GLOXIOU/MIDI-controller-DIY/images/img-26.png

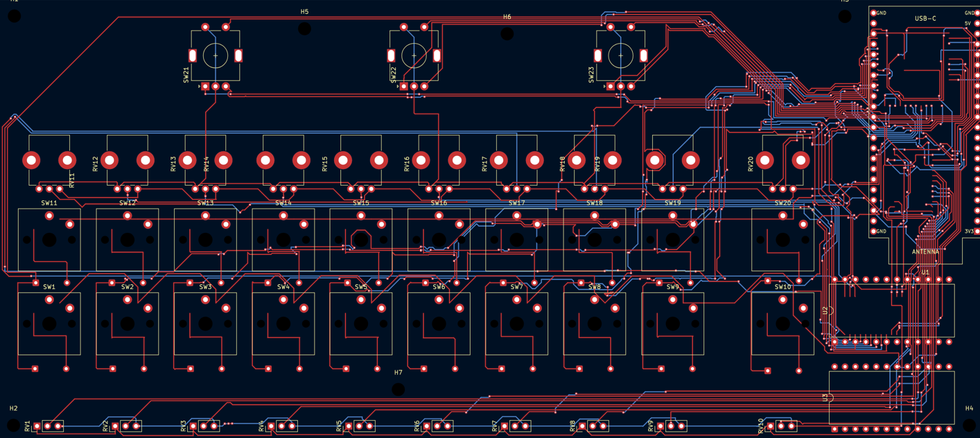
images/img-26.png
