GLOXIOU/MIDI-controller-DIY/images/img-27.png

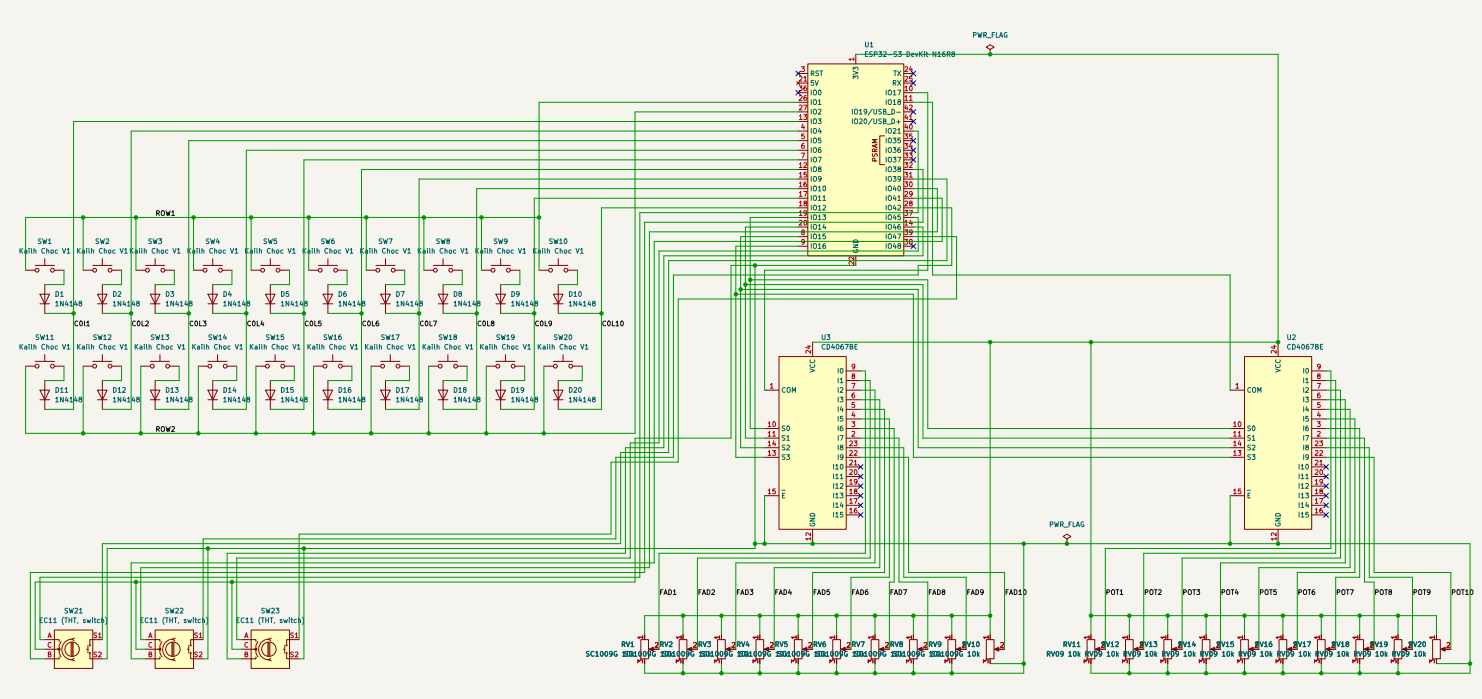
images/img-27.png
