GLOXIOU/MIDI-controller-DIY/images/img-28.png

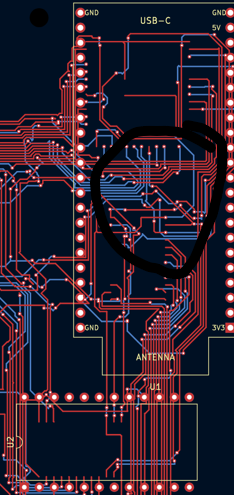
images/img-28.png
