GLOXIOU/MIDI-controller-DIY/images/img-29.png

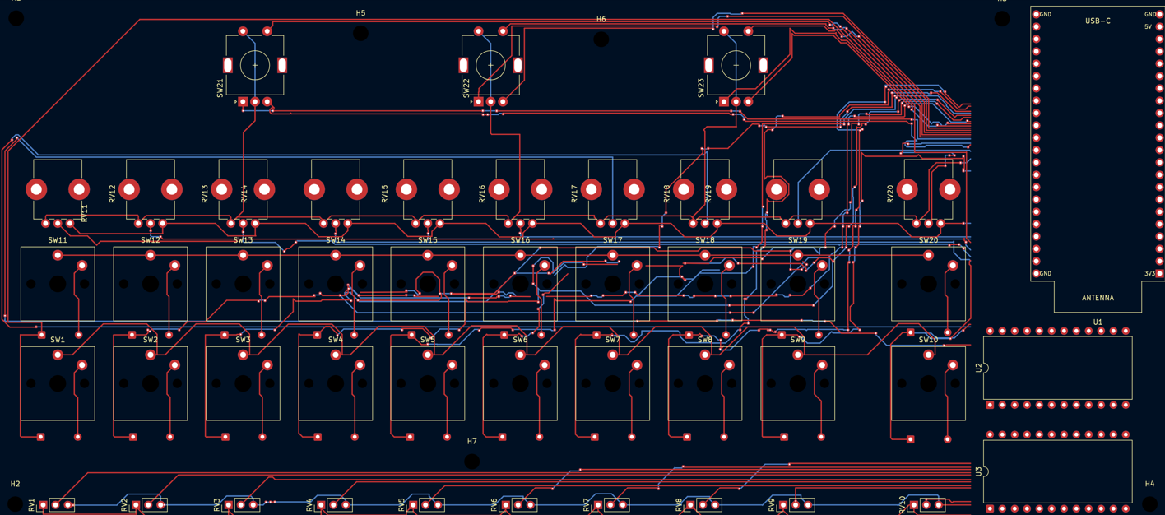
images/img-29.png
