GLOXIOU/MIDI-controller-DIY/images/img-30.png

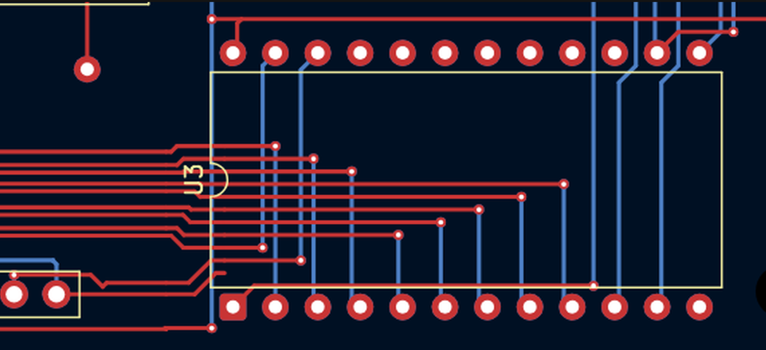
images/img-30.png
