GLOXIOU/MIDI-controller-DIY/images/img-31.png

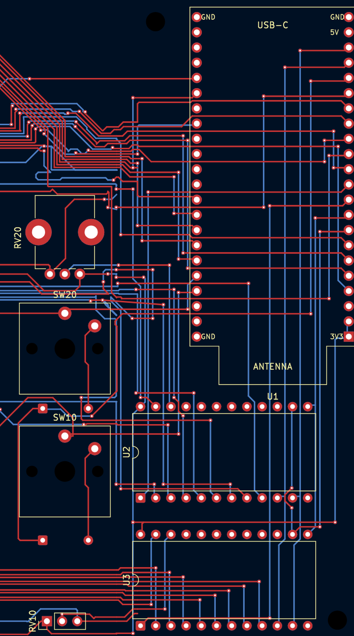
images/img-31.png
