GLOXIOU/MIDI-controller-DIY/images/img-32.png

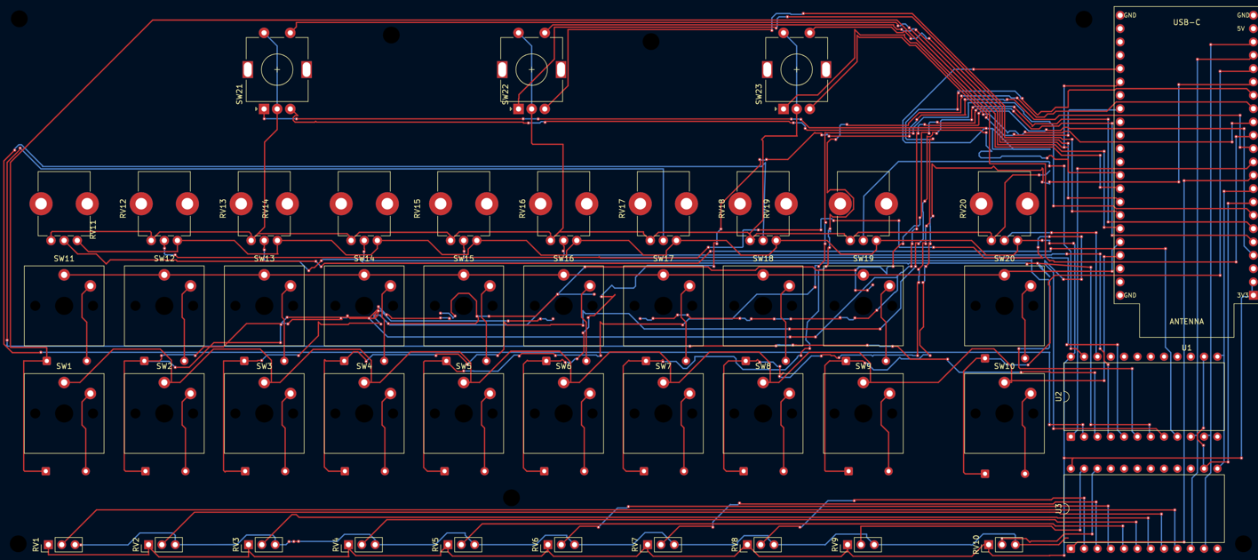
images/img-32.png
