GLOXIOU/MIDI-controller-DIY/images/img-34.png

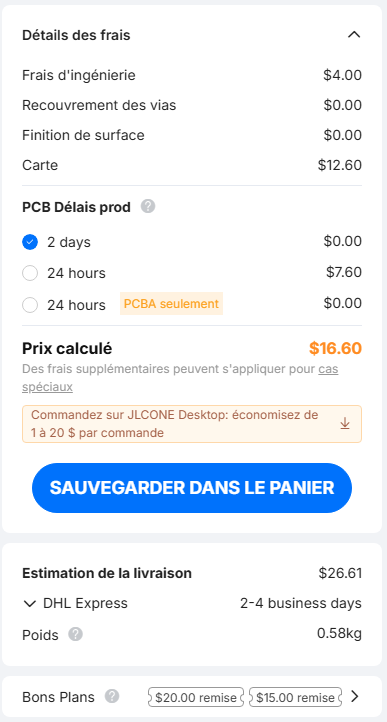
images/img-34.png
