GLOXIOU/MIDI-controller-DIY/images/img-35.png

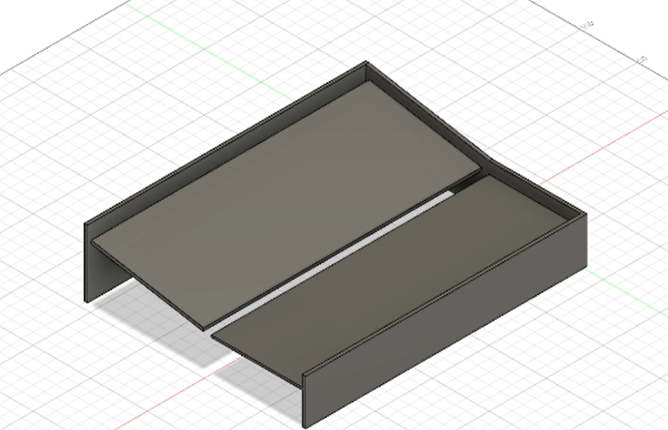
images/img-35.png
