GLOXIOU/MIDI-controller-DIY/images/img-36.png

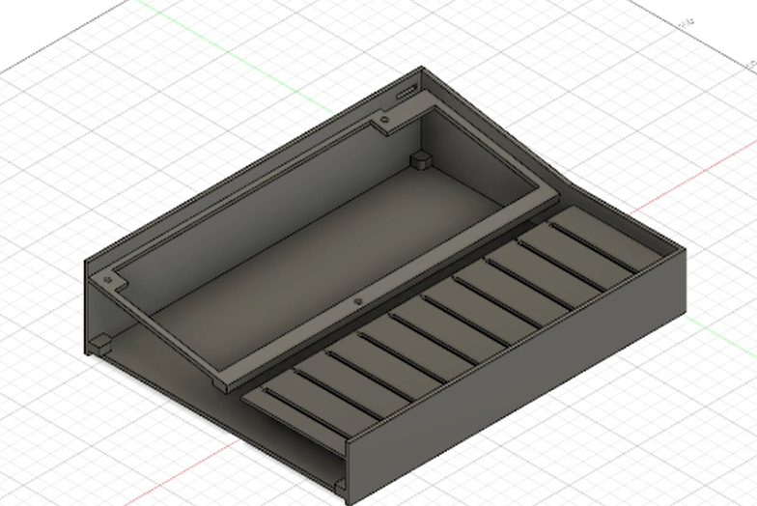
images/img-36.png
