GLOXIOU/MIDI-controller-DIY/images/img-37.png

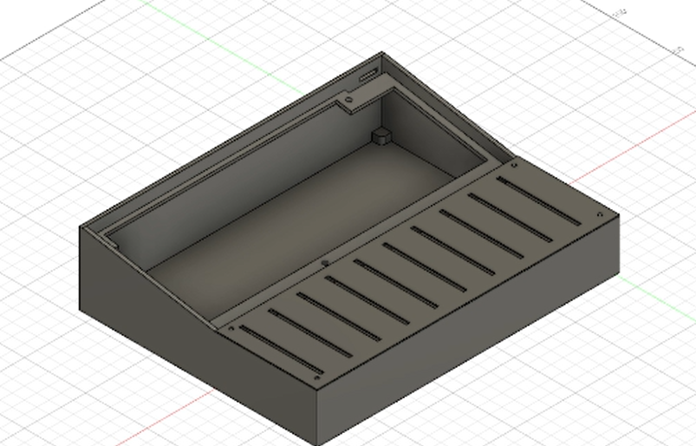
images/img-37.png
