GLOXIOU/MIDI-controller-DIY/images/img-38.png

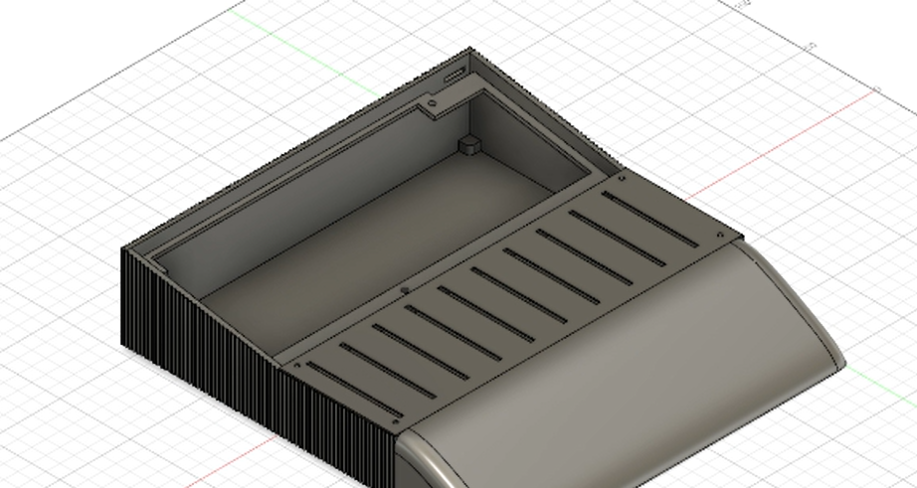
images/img-38.png
