GLOXIOU/MIDI-controller-DIY/images/img-39.png

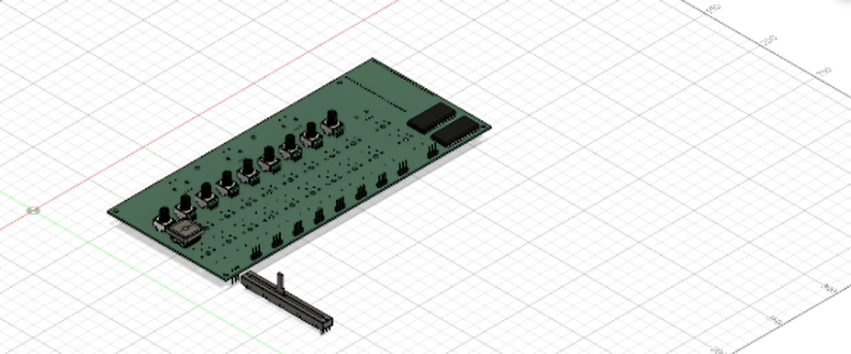
images/img-39.png
