GLOXIOU/MIDI-controller-DIY/images/img-40.png

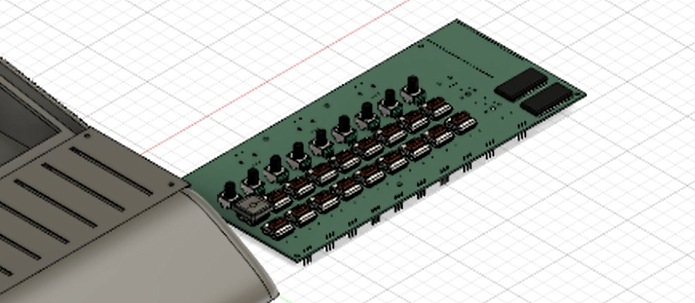
images/img-40.png
