GLOXIOU/MIDI-controller-DIY/images/img-41.png

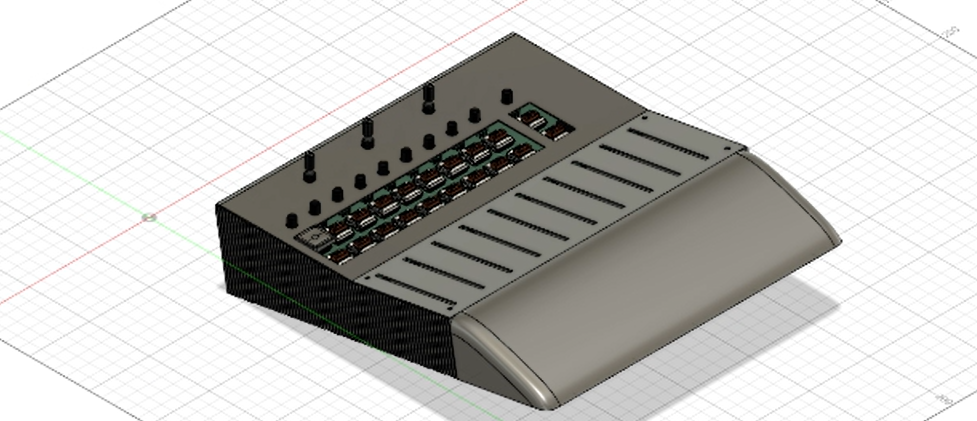
images/img-41.png
