GLOXIOU/MIDI-controller-DIY/images/img-42.png

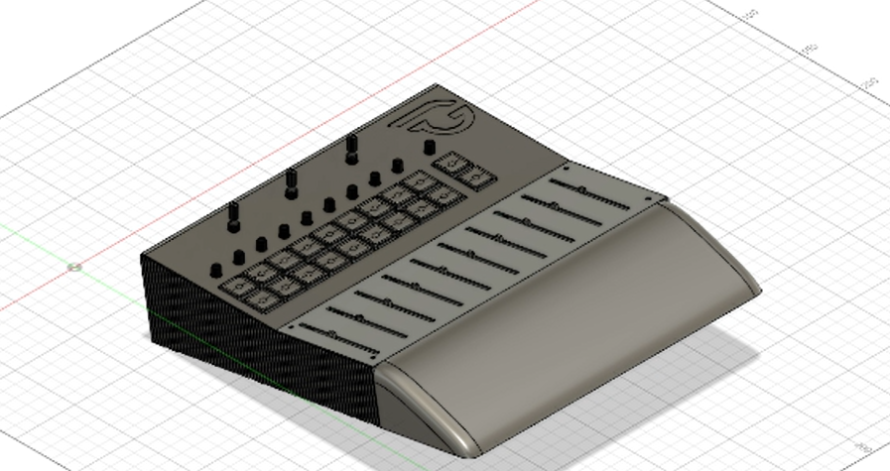
images/img-42.png
