GLOXIOU/MIDI-controller-DIY/images/img-43.png

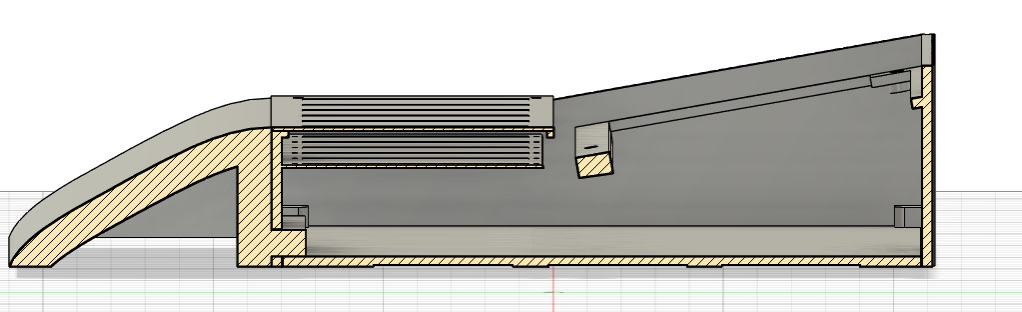
images/img-43.png
