GLOXIOU/MIDI-controller-DIY/images/img-44.png

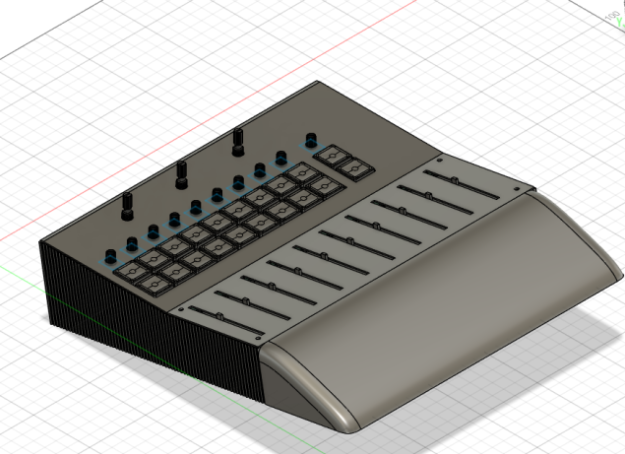
images/img-44.png
