GLOXIOU/MIDI-controller-DIY/images/img-45.png

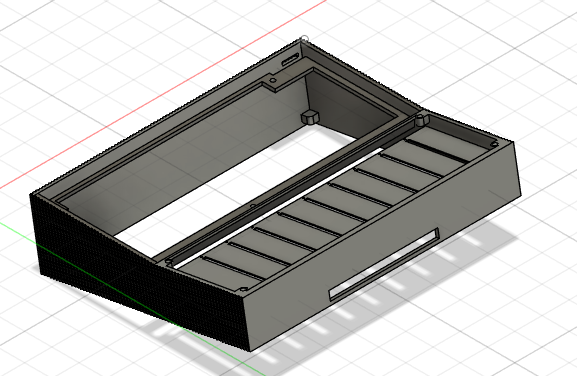
images/img-45.png
