GLOXIOU/MIDI-controller-DIY/images/img-46.png

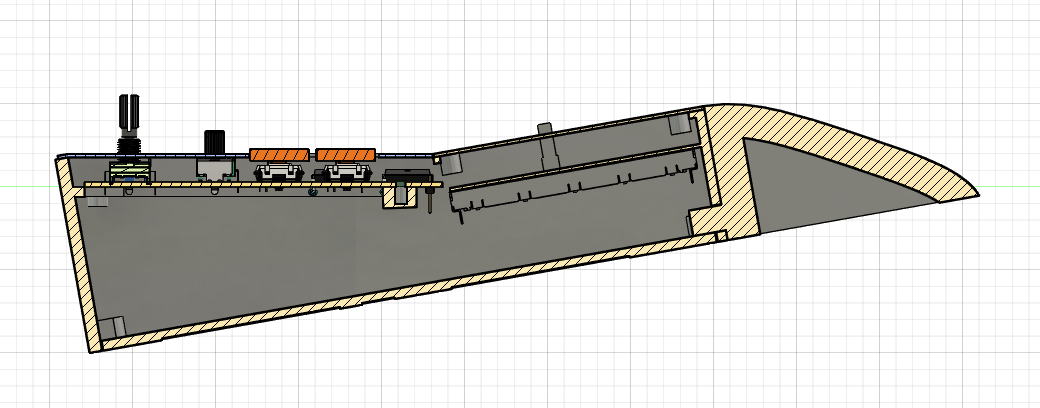
images/img-46.png
