GLOXIOU/MIDI-controller-DIY/images/img-47.png

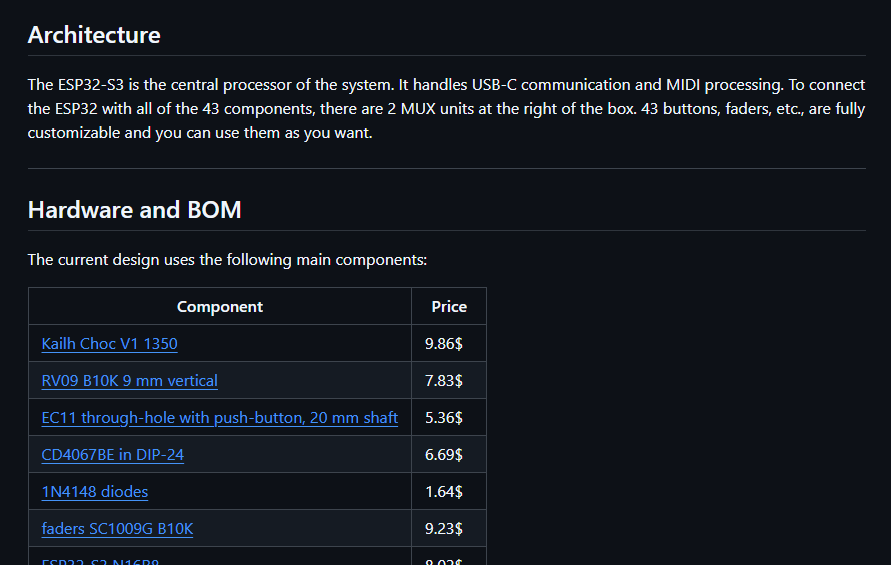
images/img-47.png
