GLOXIOU/MIDI-controller-DIY/images/img-48.png

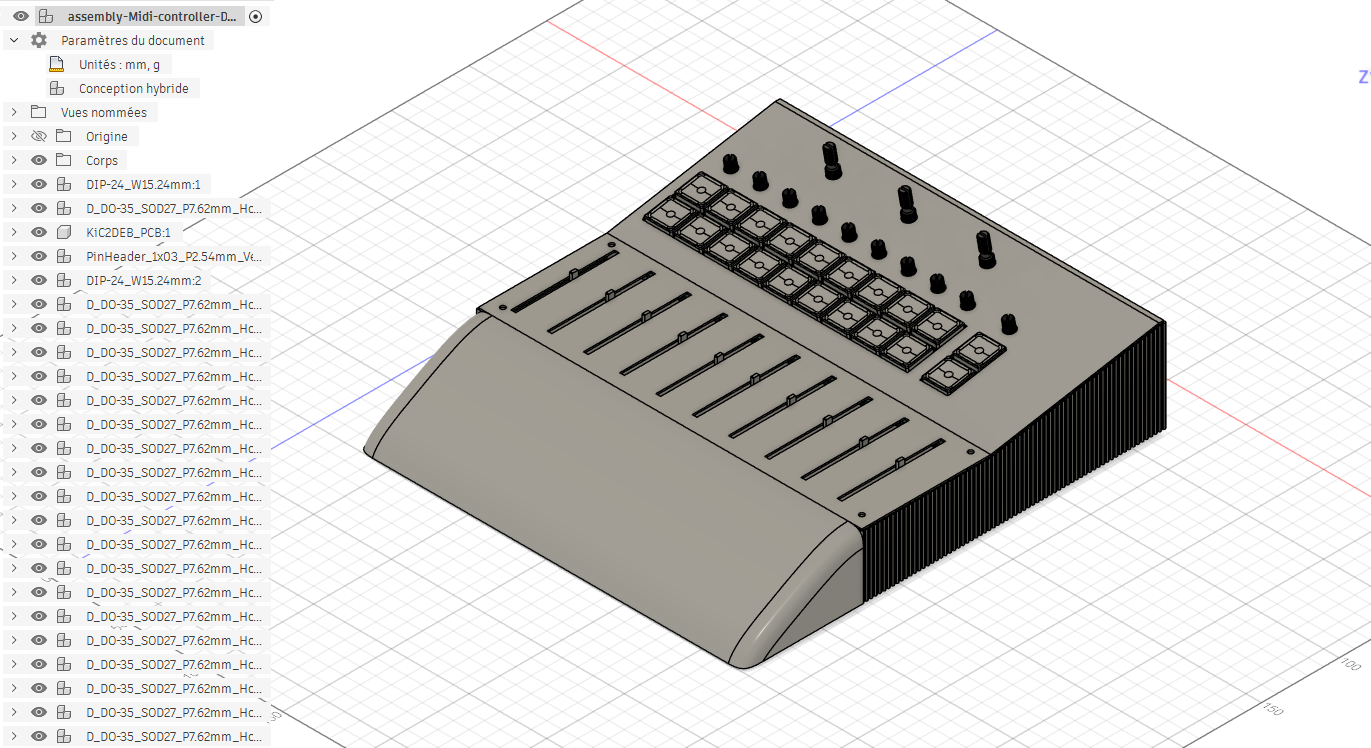
images/img-48.png
