GLOXIOU/MIDI-controller-DIY/images/img-49.png

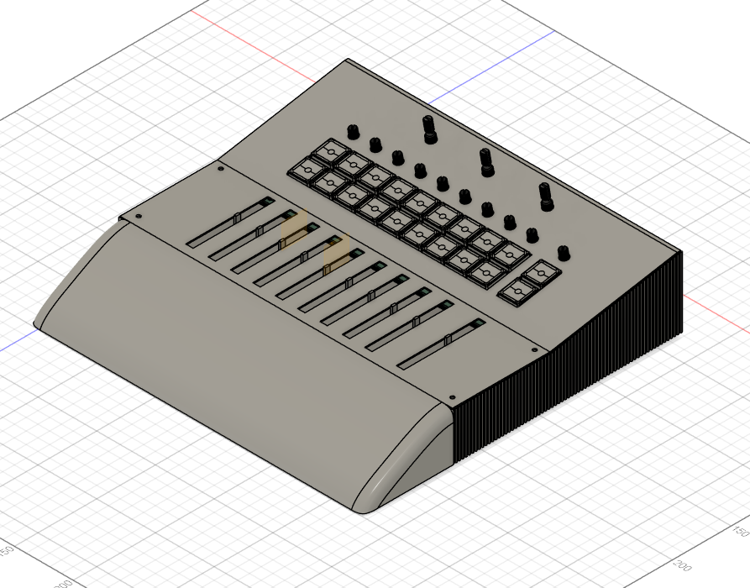
images/img-49.png
