GLOXIOU/MIDI-controller-DIY/images/img-50.png

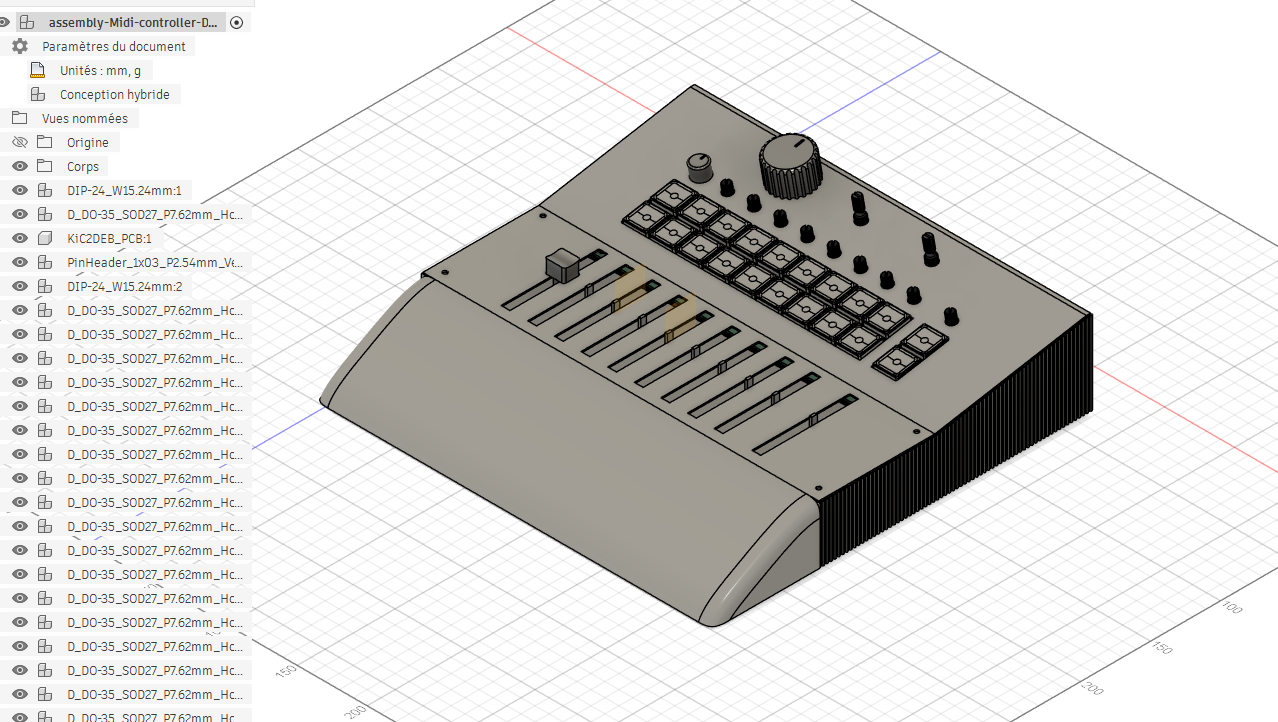
images/img-50.png
