GLOXIOU/MIDI-controller-DIY/images/img-51.png

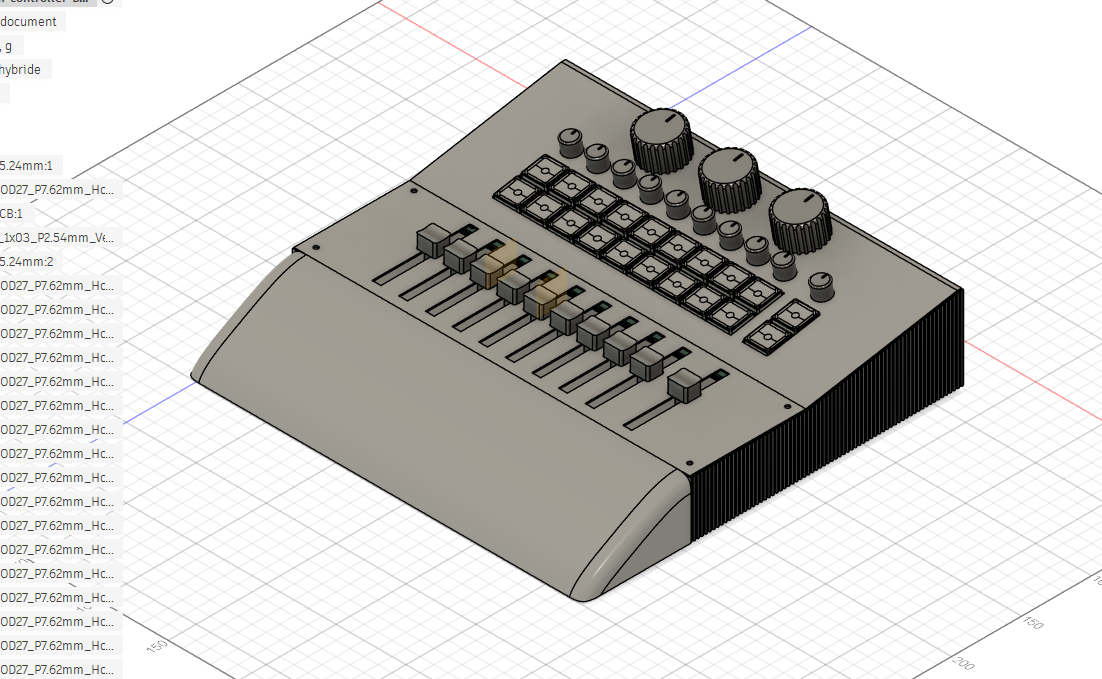
images/img-51.png
