GLOXIOU/MIDI-controller-DIY/3D-files/assembly-Midi-controller-DIY.step

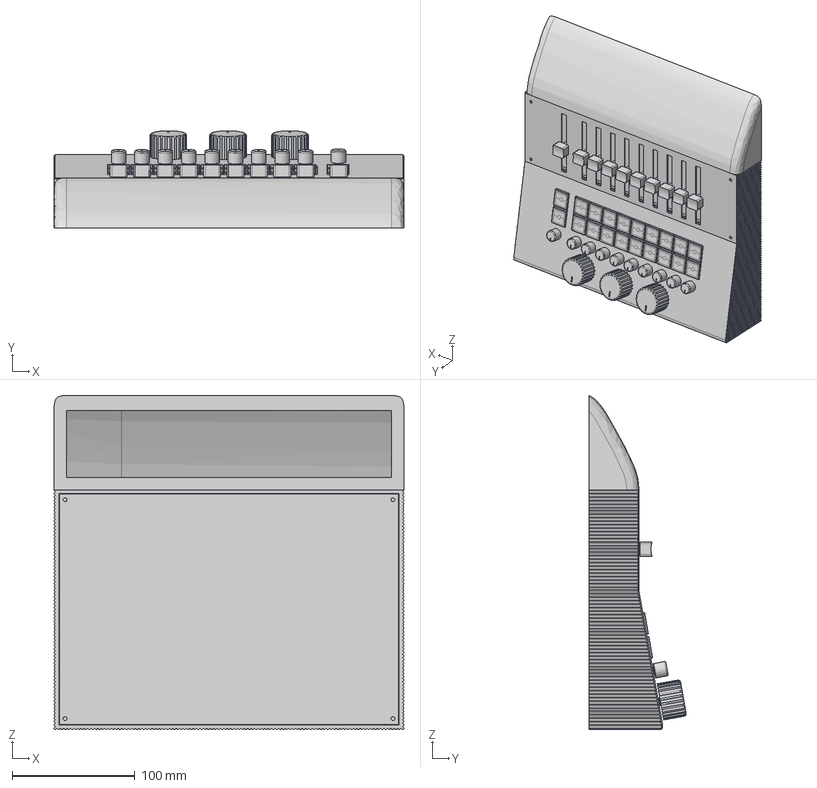
[picture p30: CAD file, 2026-11-03]
3D-files/assembly-Midi-controller-DIY.step
285.1 x 79.4 x 272.2 mm
DIP_24_W1524mm x 2
D_DO-35_SOD27_P7.62mm_Horizontal_1 x 20
KiC2DEB_PCB
PinHeader_1x03_P254mm_Vertical x 10
Document x 20
SLIDE_POTENTIOMETER_PLATE x 10
