GLOXIOU/MIDI-controller-DIY/3D-files/potentio_assem_asm.stp

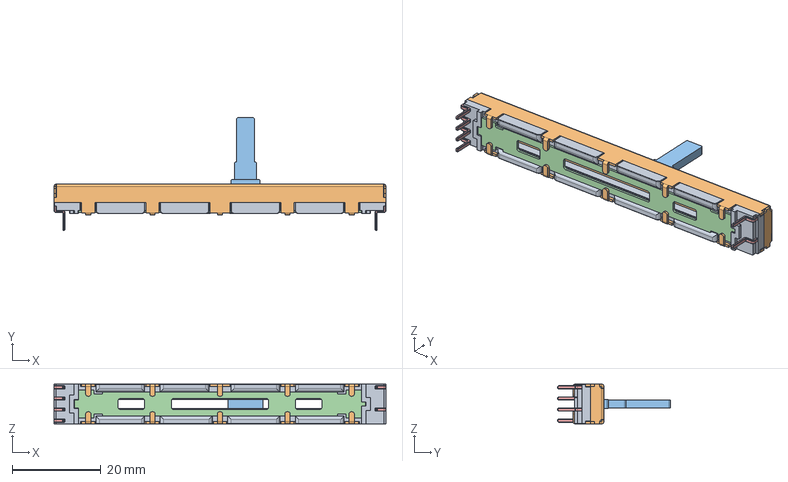
[picture p31: CAD file, 2026-10-31]
3D-files/potentio_assem_asm.stp
75.0 x 25.4 x 9.00 mm
SLIDE_POTENTIOMETER_BODY
SLIDE_POTENTIOMETER_COVER
SLIDE_POTENTIOMETER_BAR
SLIDE_POTENTIOMETER_PLATE
SLIDE_POTENTIOMETER_PIN x 6
