GLOXIOU/MIDI-controller-DIY/3D-files/Midi-controller-DIY-case.step

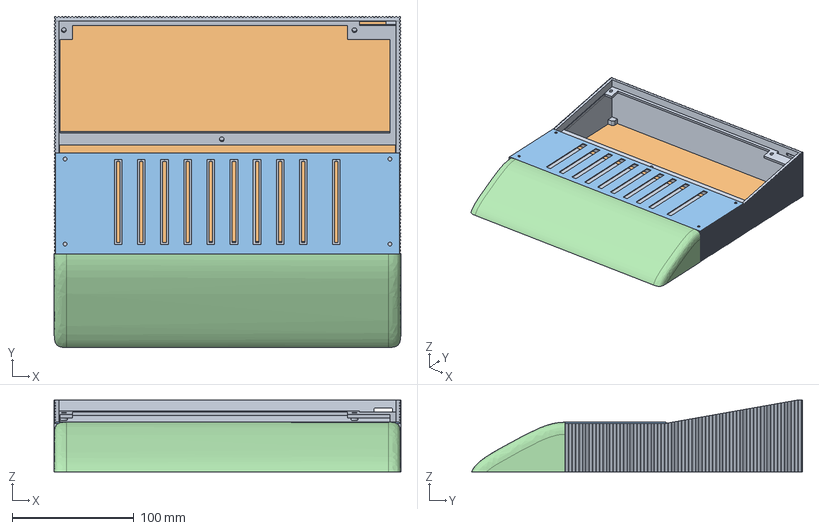
[picture p32: CAD file, 2026-11-03]
3D-files/Midi-controller-DIY-case.step
285.1 x 272.2 x 59.2 mm
