GLOXIOU/MIDI-controller-DIY/3D-files/to print/pot-knob-Midi-controller.stl

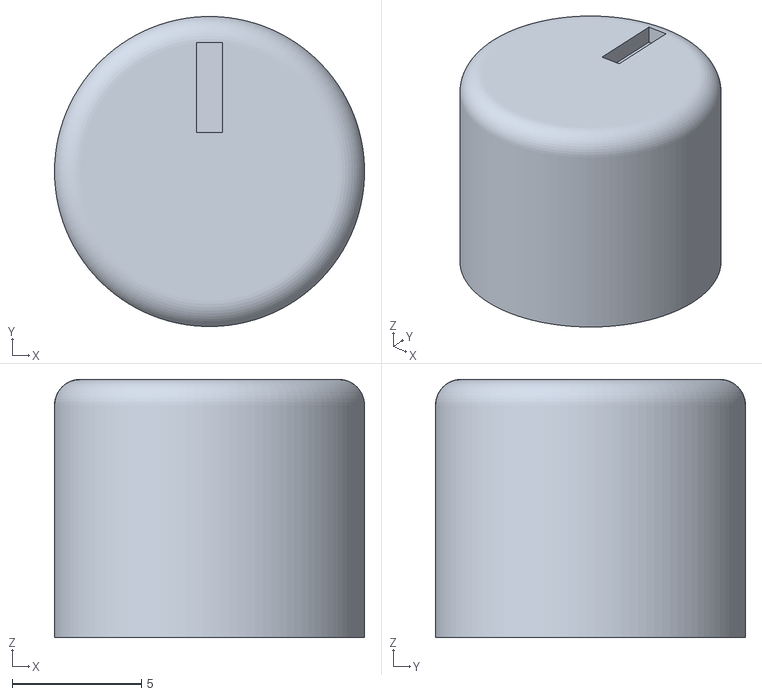
[picture p33: CAD file, 2026-11-03]
3D-files/to print/pot-knob-Midi-controller.stl
12.0 x 12.0 x 10.0
