GLOXIOU/MIDI-controller-DIY/3D-files/to print/encoder-knob-Midi-controller.stl

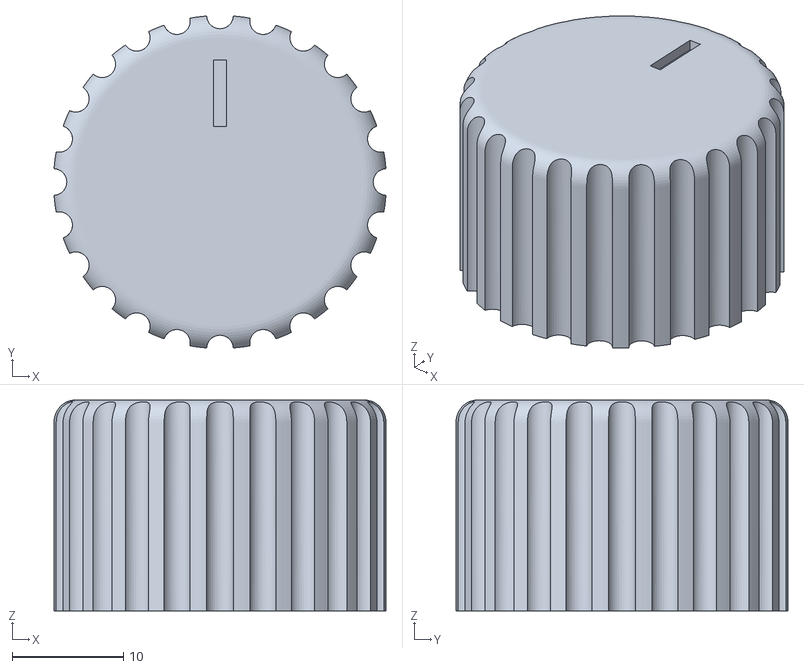
[picture p34: CAD file, 2026-11-03]
3D-files/to print/encoder-knob-Midi-controller.stl
29.9 x 29.9 x 19.0
