GLOXIOU/MIDI-controller-DIY/3D-files/to print/Wall-Midi-controller.stl

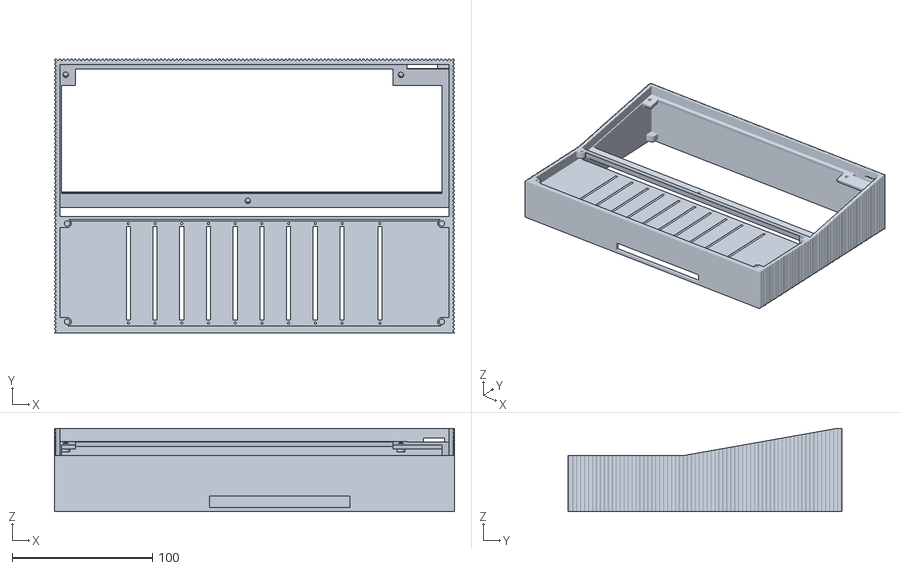
[picture p36: CAD file, 2026-11-03]
3D-files/to print/Wall-Midi-controller.stl
285.1 x 195.2 x 59.2
