GLOXIOU/MIDI-controller-DIY/3D-files/to print/ergo-Midi-controller.stl

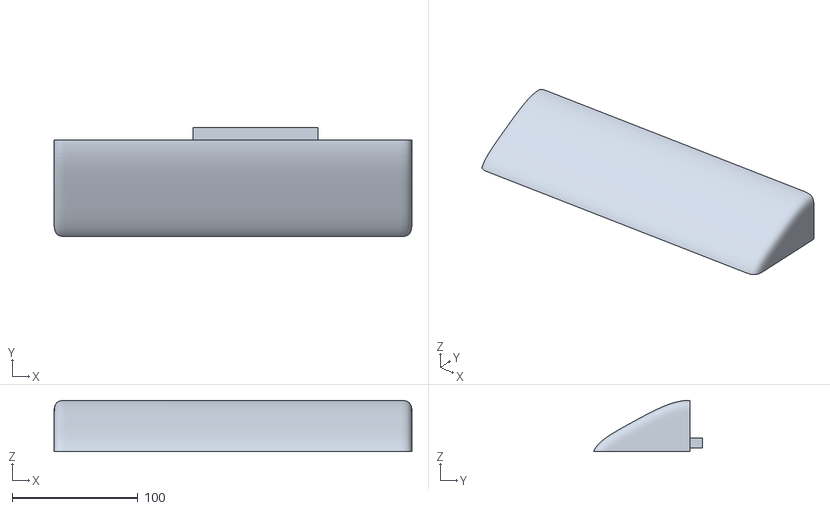
[picture p37: CAD file, 2026-11-03]
3D-files/to print/ergo-Midi-controller.stl
285.1 x 87.0 x 41.0
