GLOXIOU/MIDI-controller-DIY/3D-files/Diode 1N4148.STEP

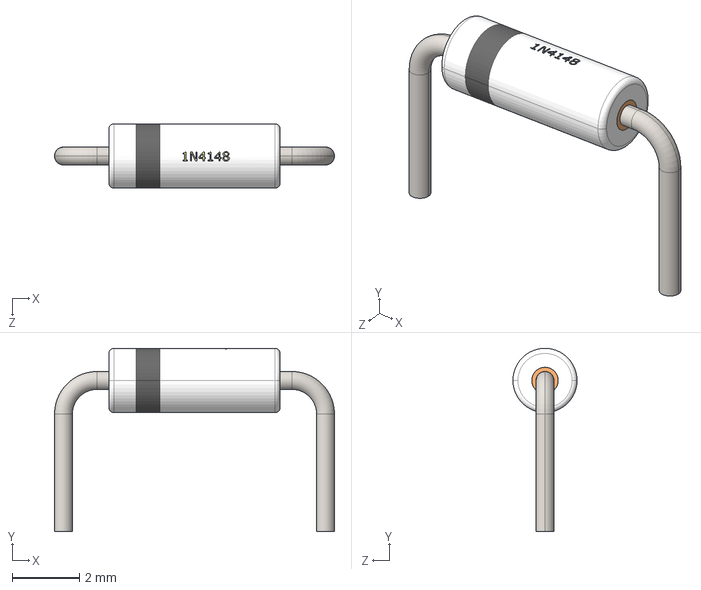
[picture p38: CAD file, 2026-10-31]
3D-files/Diode 1N4148.STEP
8.33 x 5.46 x 1.91 mm
