GLOXIOU/MIDI-controller-DIY/3D-files/to print/fader-cap-Midi-controller.stl

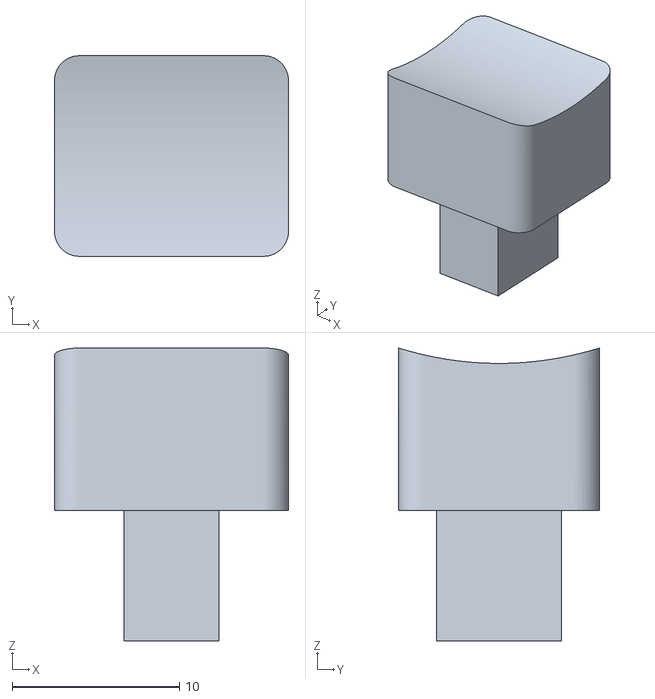
[picture p39: CAD file, 2026-11-03]
3D-files/to print/fader-cap-Midi-controller.stl
14.0 x 12.0 x 17.5
