GLOXIOU/MIDI-controller-DIY/3D-files/PCB.step

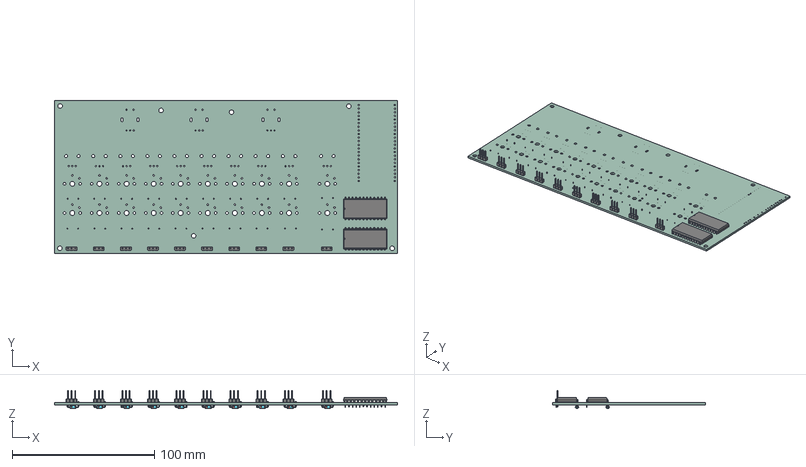
[picture p40: CAD file, 2026-10-31]
3D-files/PCB.step
241.0 x 107.8 x 12.7 mm
PinHeader_1x03_P254mm_Vertical x 10
DIP_24_W1524mm x 2
D_DO-35_SOD27_P7.62mm_Horizontal x 20
KiC2DEB_PCB
