GLOXIOU/MIDI-controller-DIY/3D-files/to print/key-plate-Midi-controller.stl

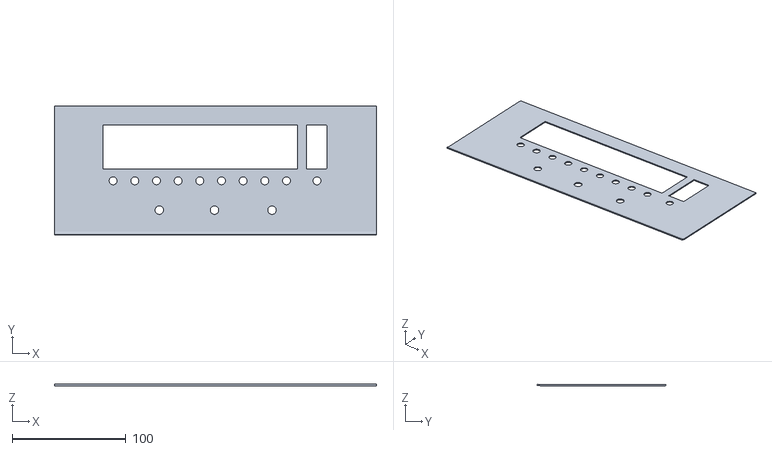
[picture p41: CAD file, 2026-11-03]
3D-files/to print/key-plate-Midi-controller.stl
283.1 x 113.1 x 1.51
