GLOXIOU/MIDI-controller-DIY/3D-files/Grove Fader Cap.step

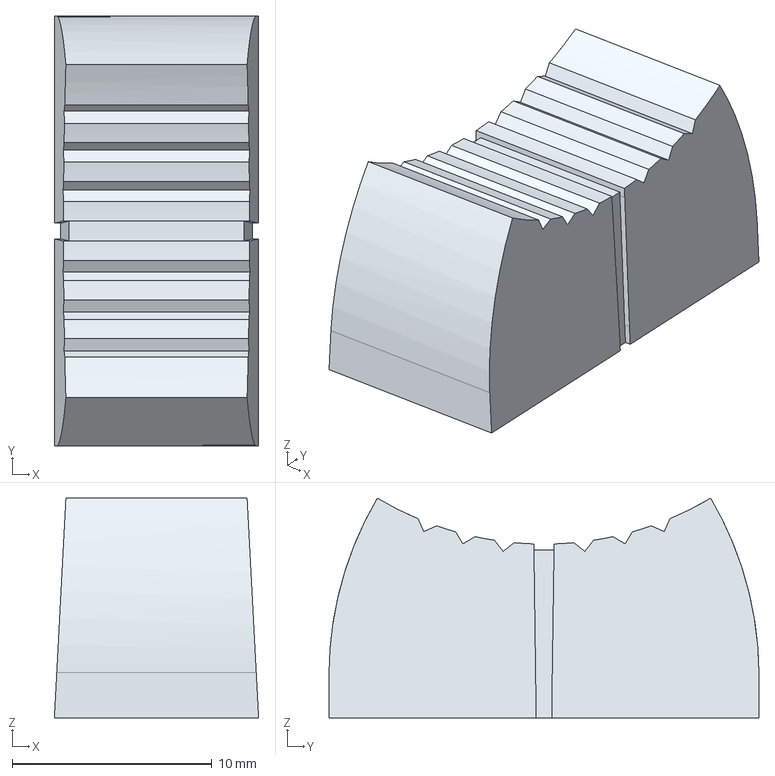
[picture p42: CAD file, 2026-10-31]
3D-files/Grove Fader Cap.step
10.2 x 21.5 x 11.0 mm
