GLOXIOU/MIDI-controller-DIY/3D-files/to print/plate-Midi-controller.stl

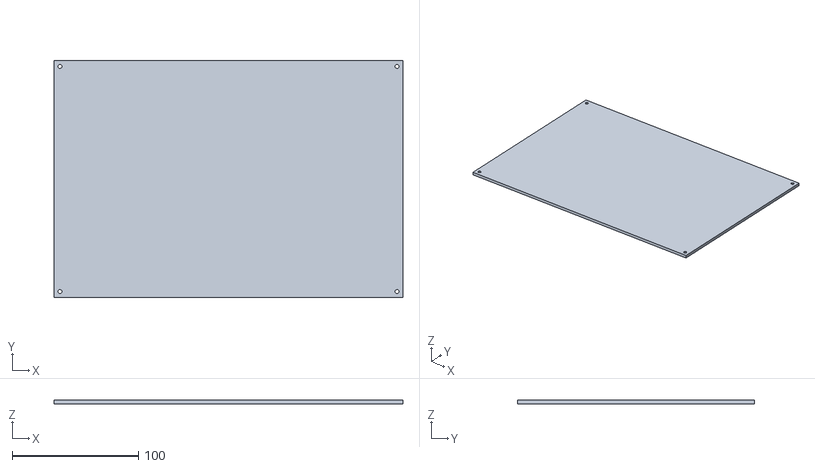
[picture p43: CAD file, 2026-11-03]
3D-files/to print/plate-Midi-controller.stl
276.5 x 187.7 x 3.00
