GLOXIOU/MIDI-controller-DIY/3D-files/to print/fader-cover-Midi-controller.stl

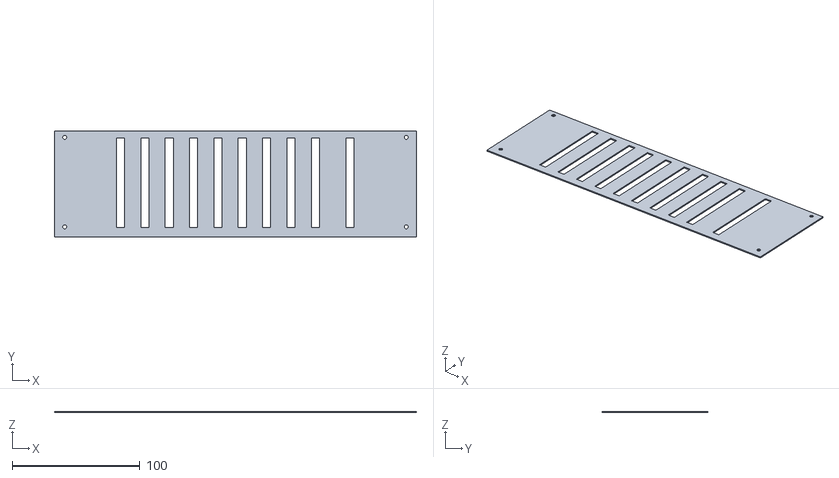
[picture p44: CAD file, 2026-11-03]
3D-files/to print/fader-cover-Midi-controller.stl
283.1 x 83.0 x 1
