GLOXIOU/MIDI-controller-DIY/JOURNAL.md

| title | MIDI-controller-DIY |
| --- | --- |
| author | GLOXIOU |
| description | A DIY project for a MIDI controller designed to control lights, featuring knobs, faders, and buttons. |
| created_at | 2026-09-23 |

# Day 1: Defining system & idea search & inspiration

I want to make a MIDI controlleur to control my lights via my already made [DMX Unit](https://github.com/GLOXIOU/DMX-Unit-DIY), with 9 faders, 1 master fader, for all of the faders, 2 keyboards low profile key, and 2 potentiometer. I also want 2 larger rotary encoders with push-button function. All of that in a box, designed in 3D in Fusion 360, and for the first time in my life with a PCB. All of that will be managed by an ESP32-S3, and I want just a USB-C output for the MIDI.

My inspiration is the GrandMa, wich cost around 7000$. I want to make that, but for much cheaper, and with just the functionality I need. The only thing I want to keep from that housing is the utility.

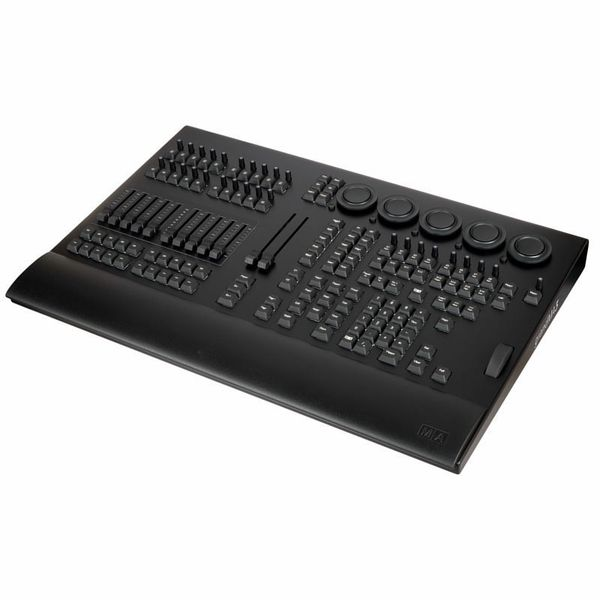
[picture p45: images/img-1.jpg]


So I started by making a litlle schema of what I want and what I imagine:

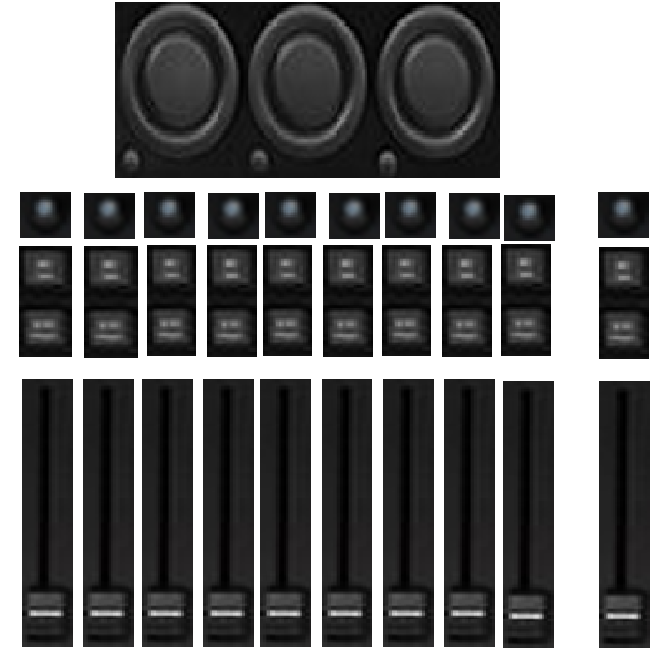
[picture p46: images/img-2.jpg]


Why 9 faders and 1 master ? Beacause on Aliexpress, tehre's only lots of 10 pieces. But that might changes, like maybe I will add 5 or I don't know. For the parts, I check online and talk to some friends, and apprenntly, this is the best:

* SC1009G Fader 10K Ohms x10
* EC11 rotary encoder x3 (I need to make the large wheel above the potentiometer in 3D)
* WH148 10K omhs x10
* Kailh 1350 Choc V1 - Brown switch x20

For a price arround 50 dollars with the PCB I believe, but it's need to be confirmed. The last time I order on aliexpress, I payed duble the price beacause of the importation tax in europe, so I need to be carefull this time...

Nothing is finished yet, but here is where the project stands at this point. Now that I have all this, I think the first step will be to design the PCB, so I can then create the 3D enclosure and finally work on the code.

Here's the actual BOM without the PCB, and the componments may changed.

| Componment | Price |
| --- | --- |
| [SC1009G x10](https://fr.aliexpress.com/item/1005005672998771.html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) | 13$ (1,30/u) |
| [EC11 x5](https://fr.aliexpress.com/item/1005006076665259.html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) | 3,71$ (0,74$/u) |
| [WH148 10K x10](https://fr.aliexpress.com/item/1005002490613561.html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) | 4,96$ (0,49$/u) |
| [Kailh 1350 Choc V1](https://fr.aliexpress.com/item/1005012826040037.html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) | 10,72$ (1,07$/u) |
| Deliverie/Importation | 16,14$ |
| Total | 60,11$ |

To that, we need to add the keycaps for the 10 keyboard key, and the PCB. ~+20$, so the total for now is around 80 dollars.

**Total time spent: 2 hours**

# Day 2: Finishing the componments grill and starting the PCB

Today I started by cheking the componments list that I mad the oder day. Turns out that it's missing something ! The ESP32 does not have enough analogics input for the project. So I made some inquiries.

I need 20 analogic signals, 10 for the sliders and 10 others for the WH148. So for those, I add 2xCD4067. They have 16 canals each, so that will be 32 in total. It's 4,67$ for 5 pices.

For the 20 low profiles keys, I need a matrix. That will reduce the number of pin from 20 to 9. But to do the matrix, I need 20 diodes 1N4148 to block the current that could flow back. That cost 1,64$ dollars for 100 pieces. That's verry cheap ! Here's a litlle schema to understand what's a matrix:

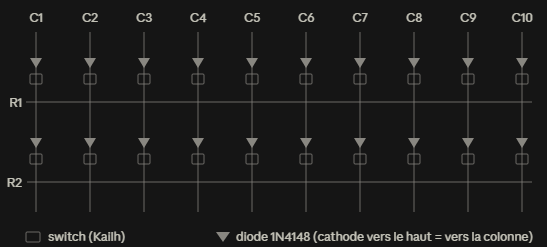
[picture p47: images/img-3.png]


So here's the new BOM:

| Componment | Price |
| --- | --- |
| [SC1009G x10](https://fr.aliexpress.com/item/1005005672998771.html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) | 13$ (1,30/u) |
| [EC11 x5](https://fr.aliexpress.com/item/1005006076665259.html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) | 3,71$ (0,74$/u) |
| [WH148 10K x10](https://fr.aliexpress.com/item/1005002490613561.html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) | 4,96$ (0,49$/u) |
| [Kailh 1350 Choc V1](https://fr.aliexpress.com/item/1005012826040037.html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) | 10,72$ (1,07$/u) |
| [CD4067](https://fr.aliexpress.com/item/1005007374271804.html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) | 4,67$ |
| [1N4148](https://fr.aliexpress.com/item/4000142272546.html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) | 1,64$ |
| Deliverie/Importation | 30,28$ |
| Total | 74,25$ |

Then, I watch [this tutorial](https://www.youtube.com/watch?v=dAck3bxzehA) of KiCad. I never done a PCB in my life, so that will not be easy. I watch it multiple time to understand how to do all the things.

Now that I know a litlle bit how to do it, with the help of the tutorial, I'm going to make the KiCad file. I started by the matrice, here's a litlle screenshot. I love making that, that's so interesting !

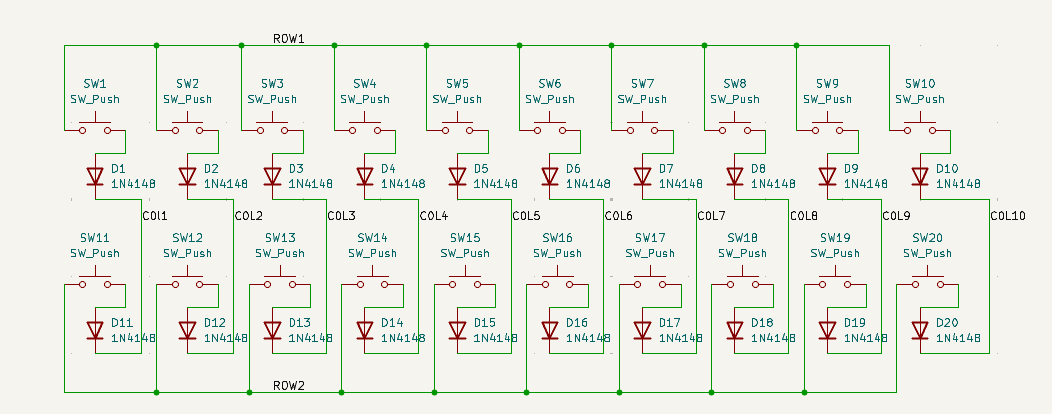
[picture p48: images/img-4.png]


Then I connected that to the ESP. I will continue tomorrow.

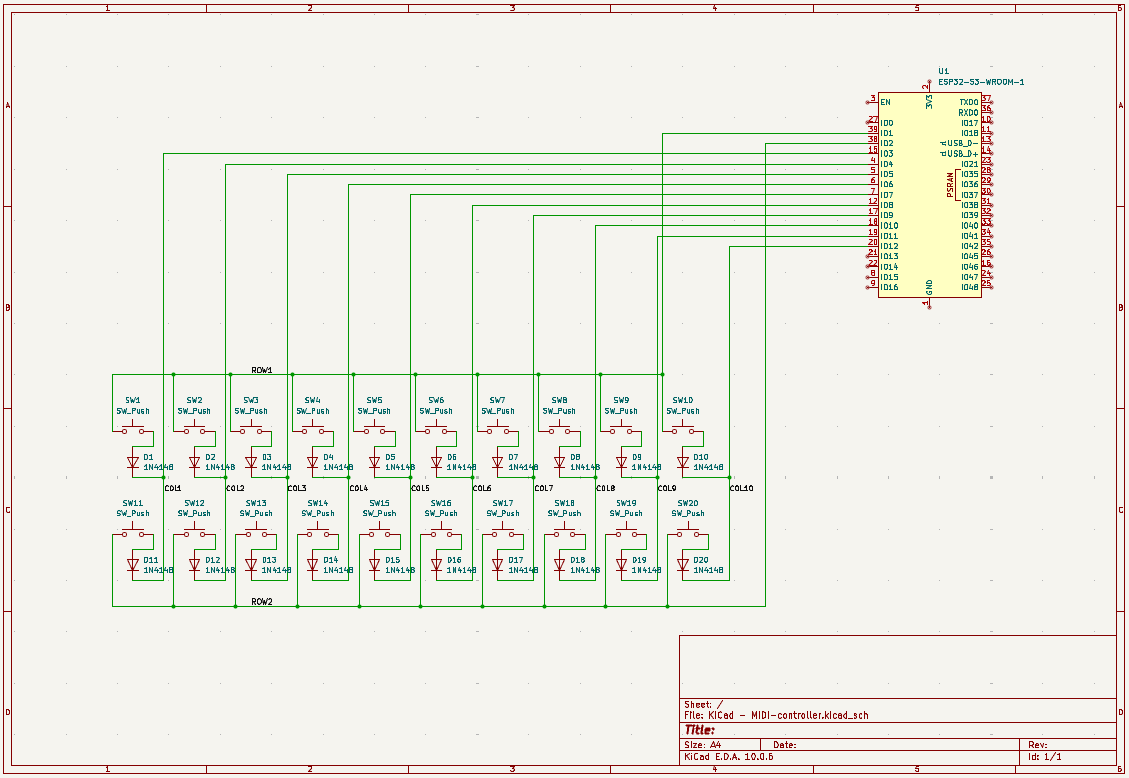
[picture p49: images/img-5.png]


You can check all the KiCad related file in [this foleder](KiCad - MIDI-controller) if you want to !

**Total time spent: 3.5 hours**

# Day 3: Finishing the KiCad plan and testing

I started by importing the 2 CD4067.

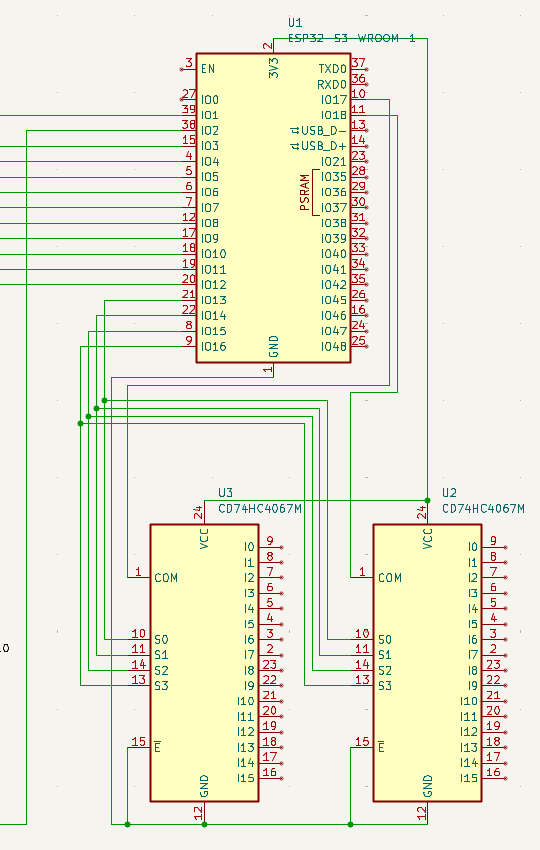
[picture p50: images/img-6.png]


Then, I added the 10 faders, SC1009G on the first MUX1 (U3 module on the screenshot). I needed to enlarge the sheet, which is why some elements shifted:

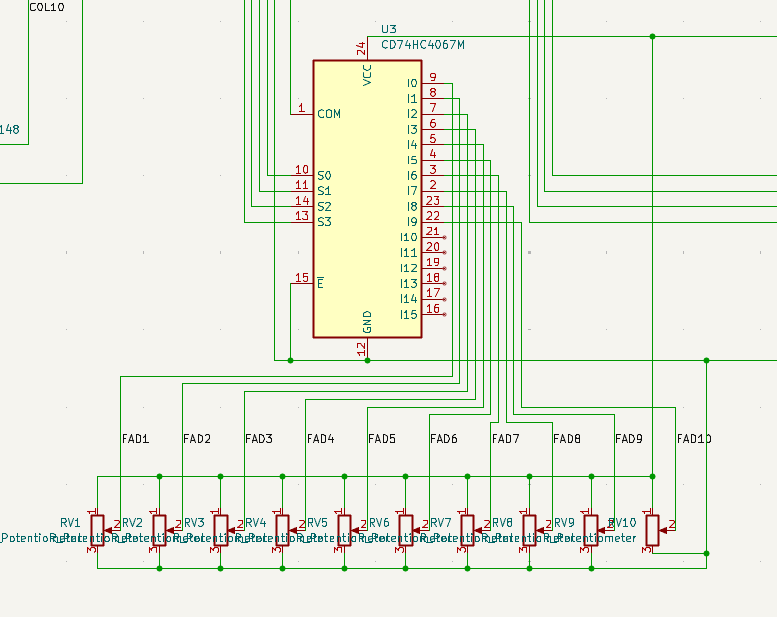
[picture p51: images/img-7.png]


Same thing for the 10 potentiometer WH148, but on the second MUX2, U2:

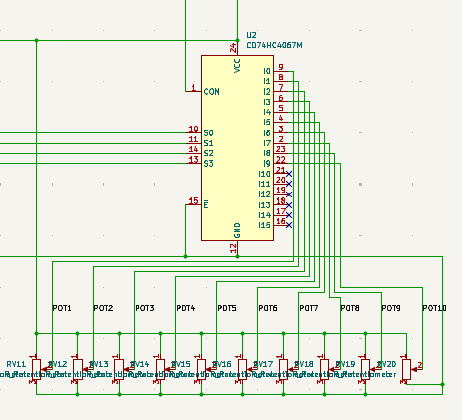
[picture p52: images/img-8.png]


After that, I aded the 3 rotary encoder switch and connected it on the ESP32:

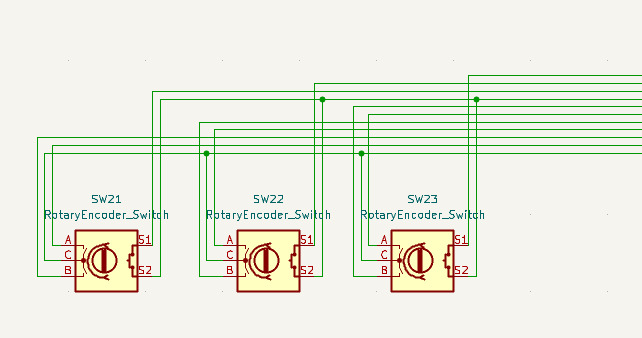
[picture p53: images/img-9.png]


So here's the final look of the KiCad sheet. Later, I'll send it to someone on Slack who knows KiCad well, so they can check that everything is working properly.

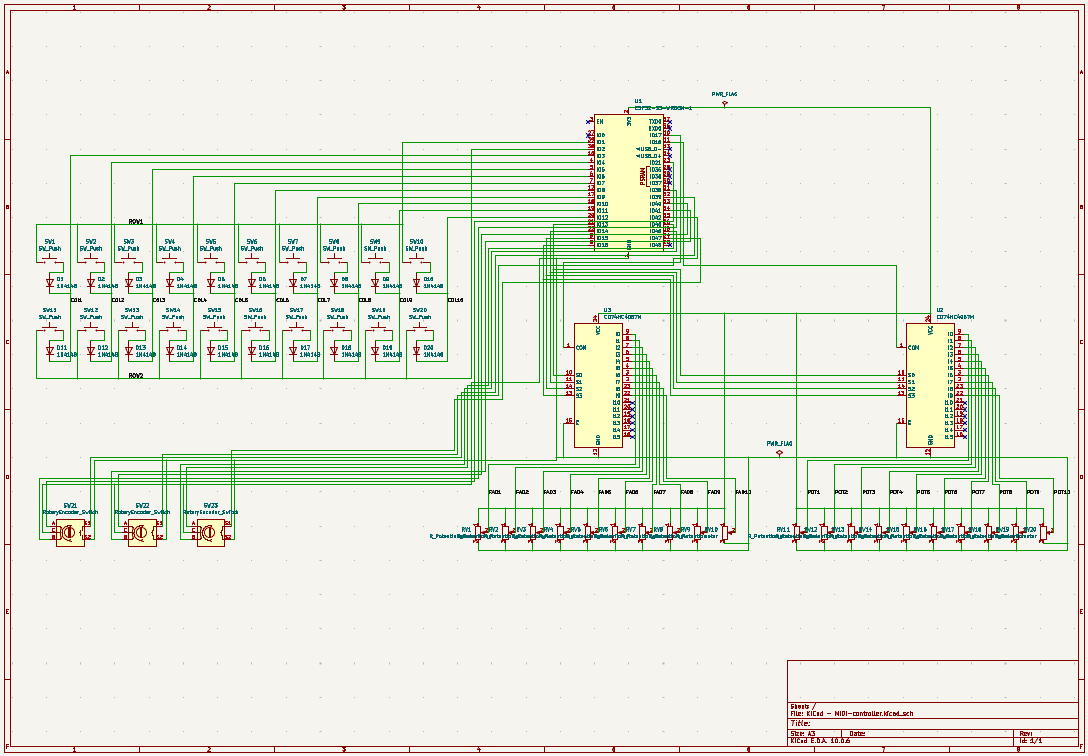
[picture p54: images/img-10.png]


I finished by making the ERC test, wich past easaly.

Today was a lot of KiCad, this is why there's not much texte for today, but a lot of screen shot ! You can check all the files in [this folder](KiCad - MIDI-controller).

**Total time spent: 3 hours**

# Day 4: Starting the PCB

Like yestreday, today will be a lot of screenshot and not much texte. Now that I finished the KiCad plan, I need to make it a PCB.

So I continued to follow the tutorial, and started by updating the PCB in the PCB window of the logiciel. But, when I pressed F8 to update, a pop up showed up with 22 errors. Since I don't know anything about the software, I sent this screenshot to an LLM, which explained how to fix the problem.

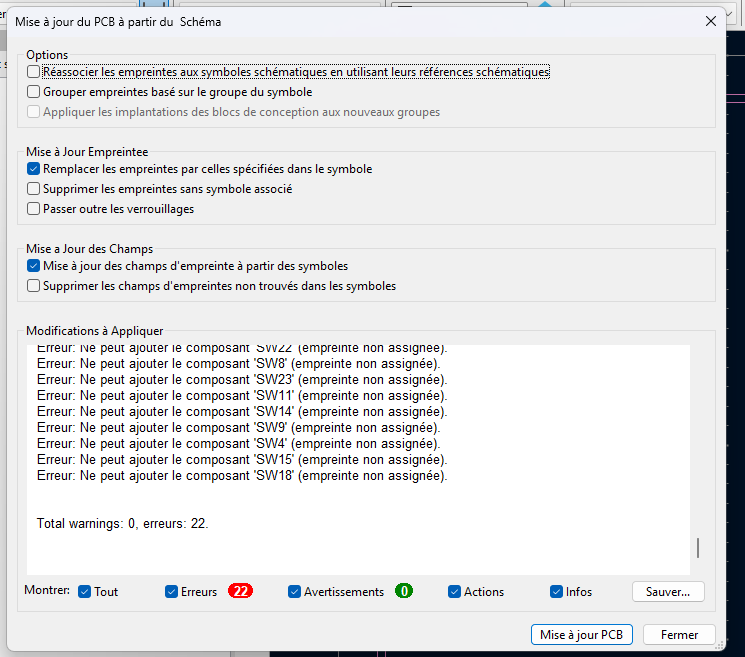
[picture p55: images/img-11.png]


Turns out that I just needed to assign the fingerprints... But that took me so much time ! I had to search online for the footprint of each of my components to add them to KiCad, find a workaround when those footprints weren't available in KiCad, and then double check everything at the end component by component... 

On top of that, I had to start all over again because I hadn't realized I needed to double click the fingerprint in addition to saving it... I won't make that mistake again !

Here is what it looks like:

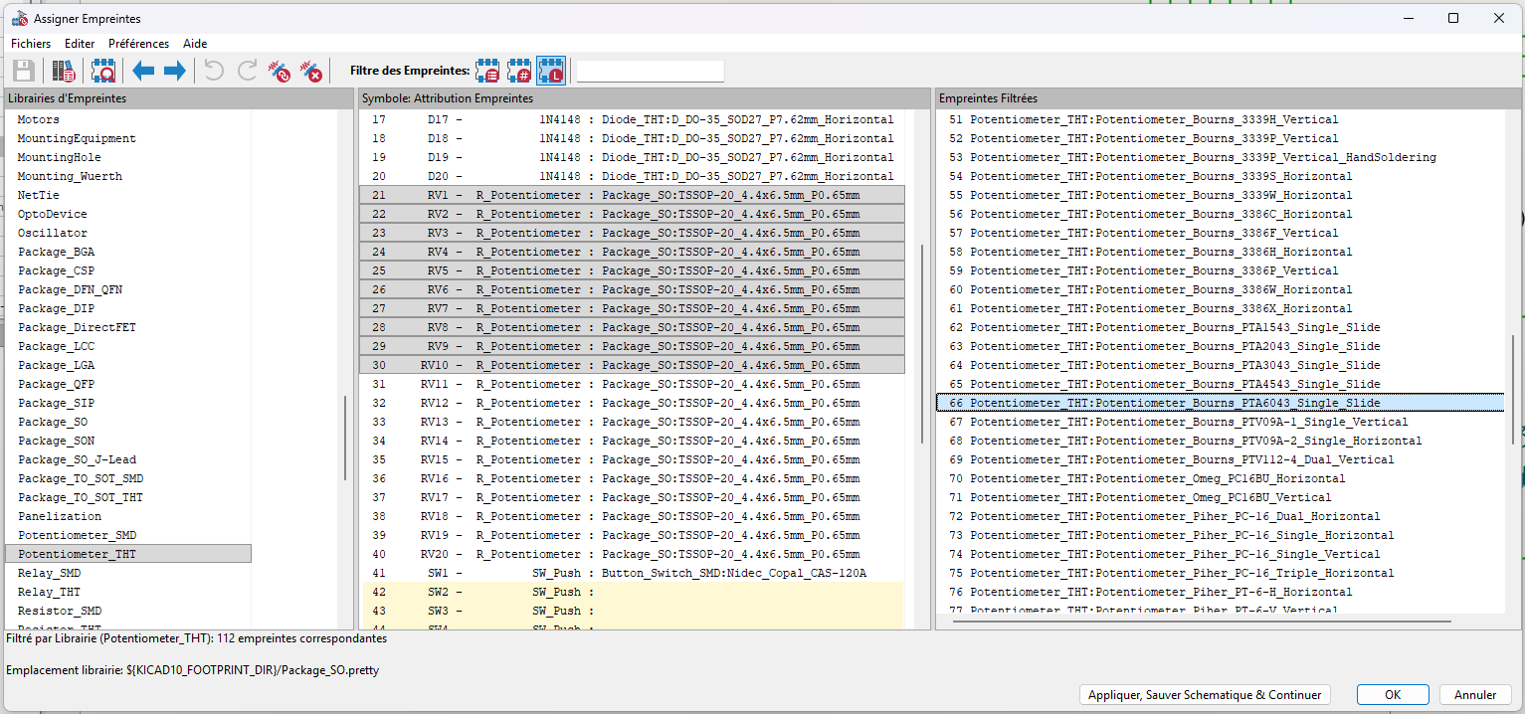
[picture p56: images/img-12.png]


So I did it, and now I can update the PCB without errors. Here's what it's look like for now, but it's verry unorganized, so I need to separate and place like I want all the compnments. The only problem is that I didn't find the right fingerprint for the fader, right now on the PCB it's some 60mm fader, so I need to check that later !

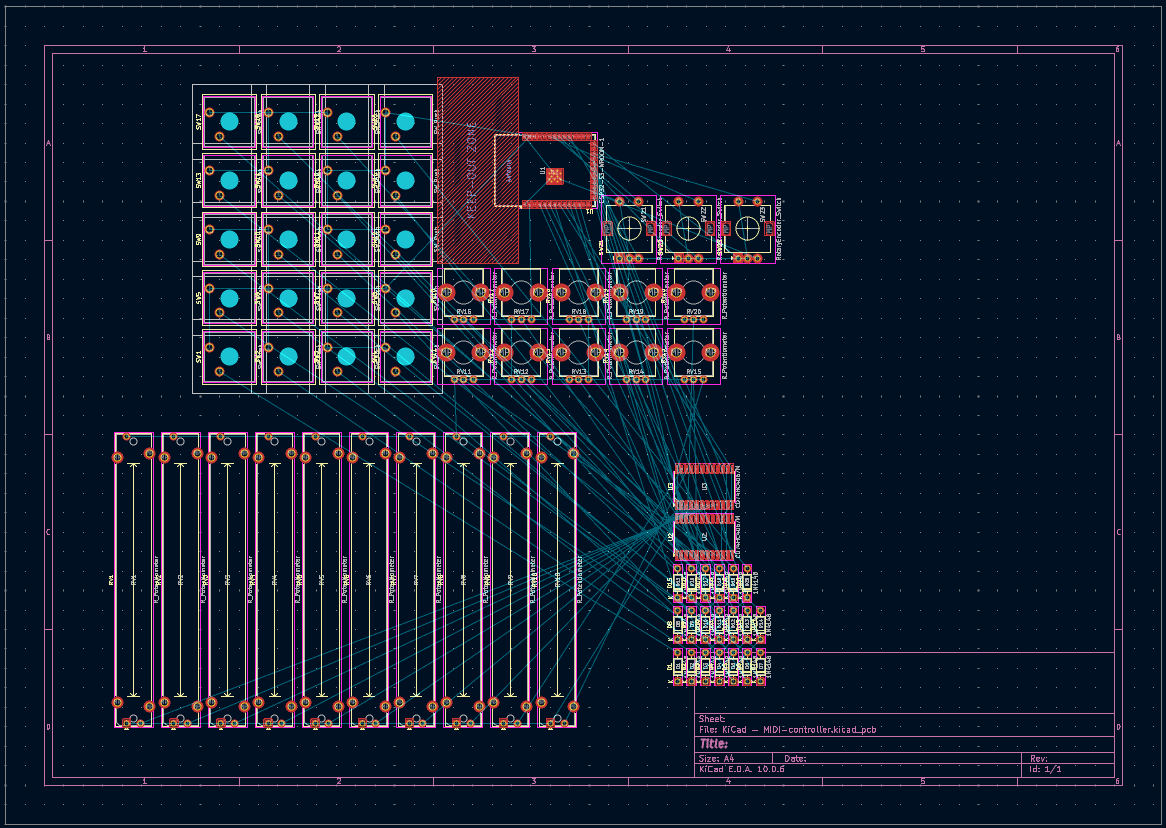
[picture p57: images/img-13.png]


Placing all the componment was also a long time to pass, but now it's done ! I’ll spare you the details regarding key spacing, vertical and horizontal alignment, the grid, and so on but of course, all of that was done!

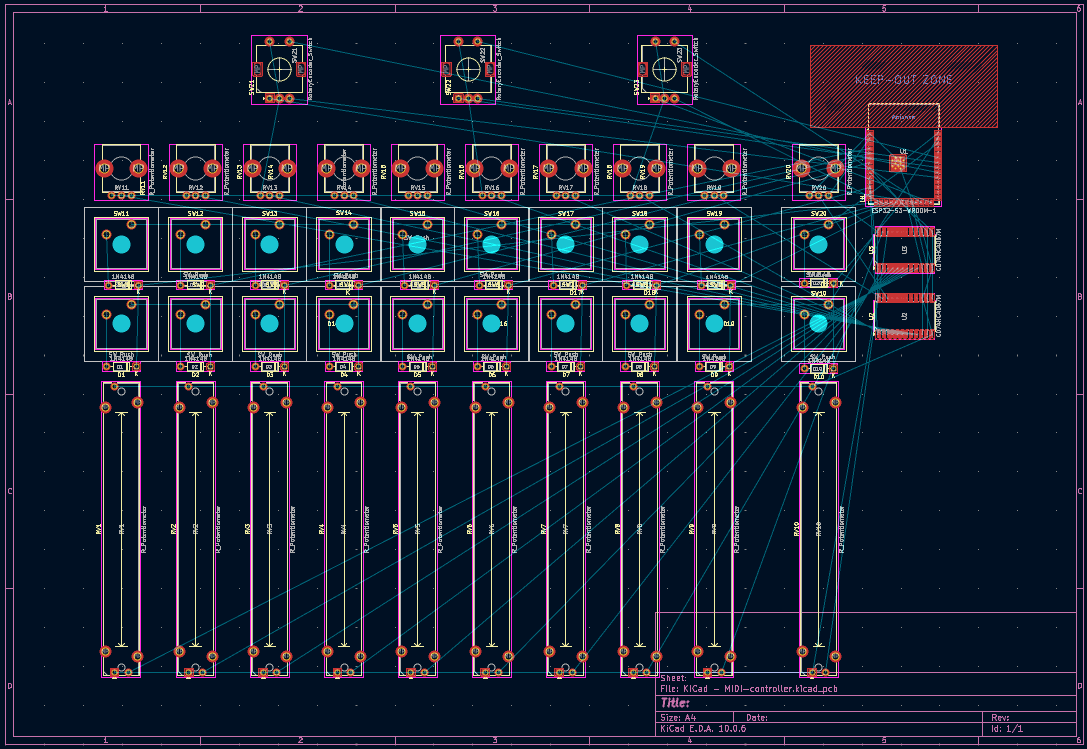
[picture p58: images/img-14.png]


Now I need to make the faders 100mm, and I need to trace the PCB outlines, and finish other stuff ! There's still a little bit of time left ! But for today, it's finished ! It might not look like it, but placing all the components in the right place and at the right distance took me a lot of time.

**Total time spent: 3 hours**

# Day 5: Continuing the PCB

I started by making the faders 100mm instead of 60mm. But, I spent an hour to look for a 100mm fingerprint, with NO result... So I’ve decided to change things up. I’m simply going to wire the faders directly, that way, I can avoid using a PCB and cut costs. I put the ```Connector_PinHeader_2.54mm:PinHeader_1x03_P2.54mm_Vertical``` fingerprint insted.

Then, I inverted the diodes on the back of the PCB, so I have the spac to put the keabords keys. Here's how the plan look right now:

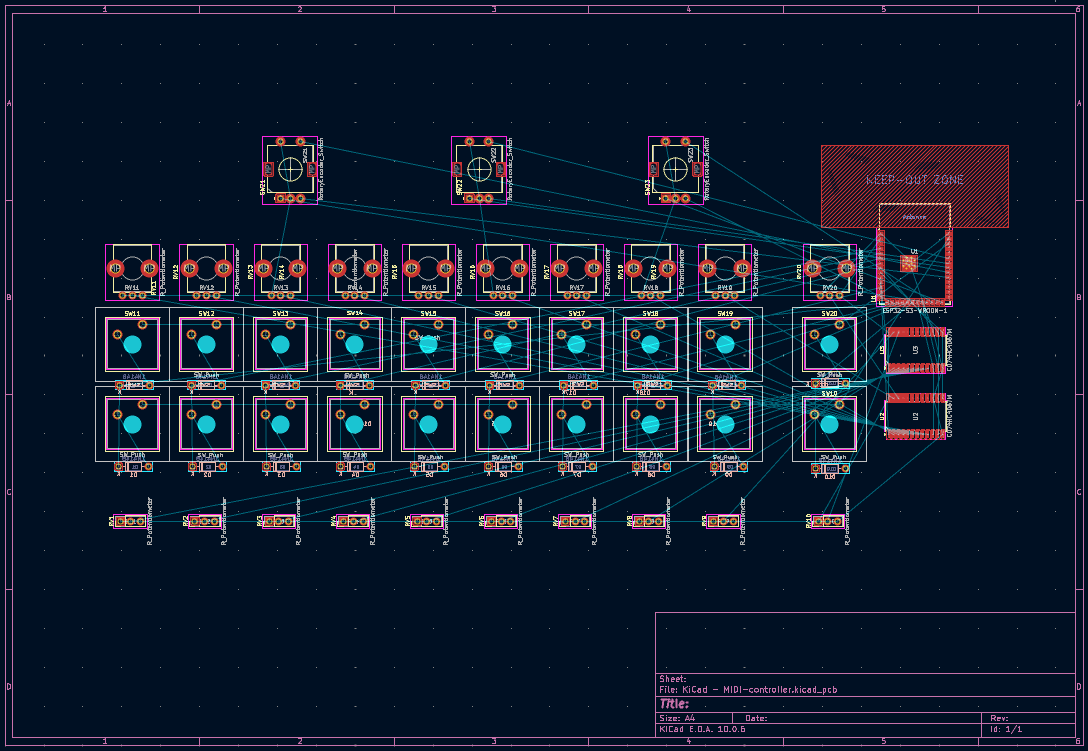
[picture p59: images/img-15.png]


After that, I drew the edge cut, and start the routing. I started by setting the track width to 0.25 mm in the settings.

I started by wiring up the entire matrix. I honestly thought it would take longer, but it wasn't bad! The most time-consuming part is the long connections linking the matrix to the ESP32. On this screenshot, these are all the small red connections.

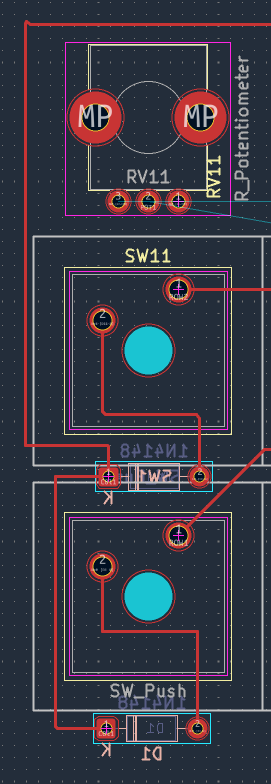
[picture p60: images/img-16.png]


The, I made the analogic connection, for the rotary encoder. For the rotary encoder, that was verry long and hard ! Beacause I needed to go all the way to the MUX... Here's how it's looking rihgt now:

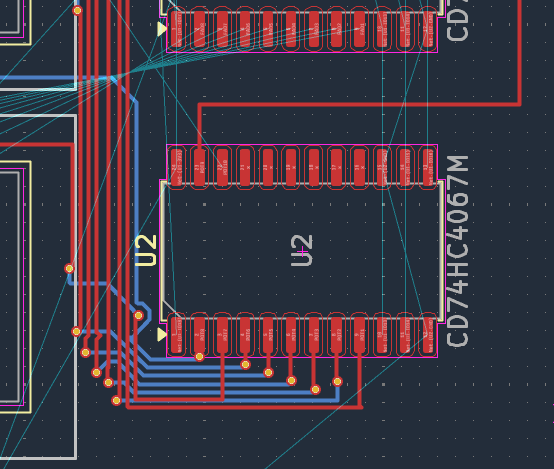
[picture p61: images/img-17.png]


It might not be very neat, but there are so many wires to run! I did the best I could. So after that, I made the wiring fot the faders.



And it's all for today ! The only thing that's missing are the three large rotary encoders and the MUX/ESP32 connections. That really won't take long.

**Total time spent: 3.5 hours**

# Day 6: Finishing the PCB ! Finnaly...

I'm starting to get fed up with making this PCB... I hope it'll be finished soon !

I started by tackling the wire routing. First, I finished wiring the faders I only had two left to do and then I started working on the three rotary encoders. I needed to enlarge the PCB just a little bit. So here's how it's looking so far



That is verry long, I had to start almost all over again because I had glued the ESP32 and the MUXes too close together. I shamefully thought I was going to have to abandon the project because of the PCB, but with a lot of time, I managed to fix the problems.

Here is the area I moved and where I had to redo a large part of the routing:

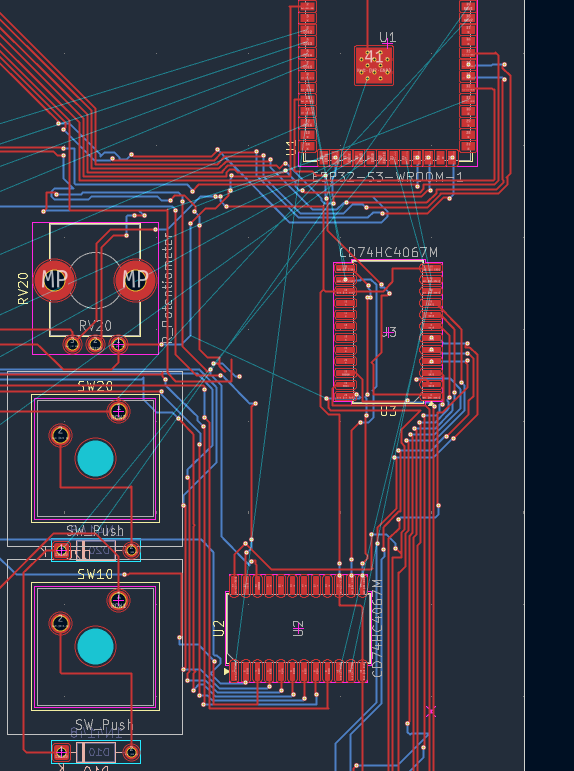
[picture p62: images/img-20.png]


Now that I have made that, I just need to wired up a few bits on the matrix, and finished off the wiring between the ESP and the MUXes. Here is the final result, finally ! All of that fixes was ssooooo long !

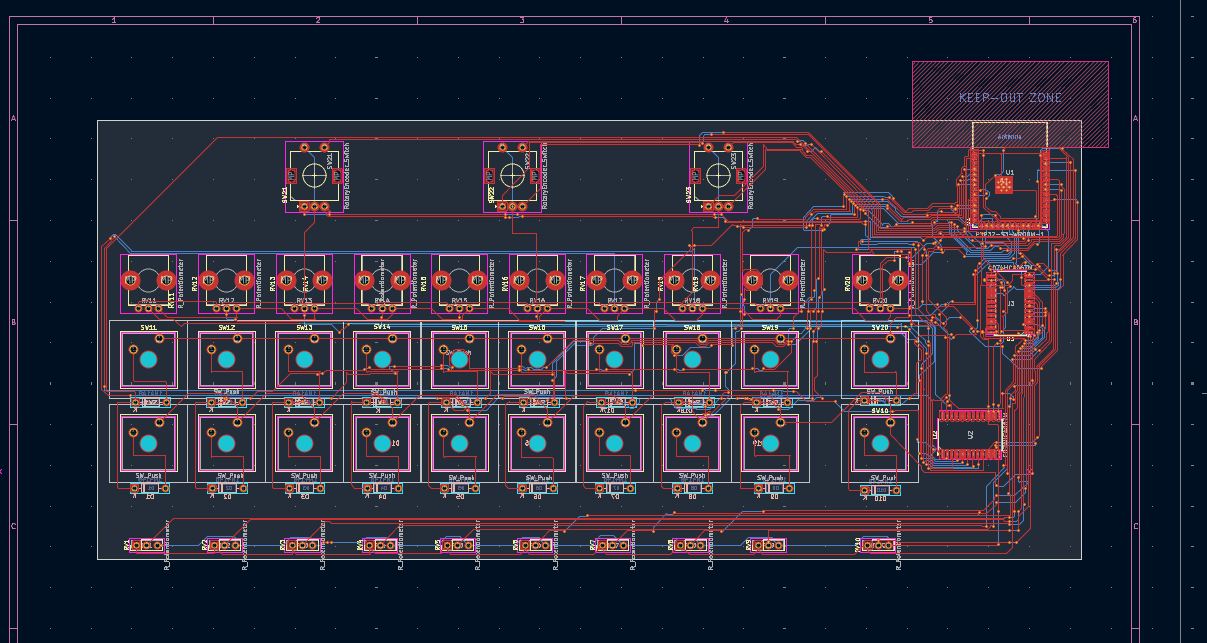
[picture p63: images/img-21.png]


I really enjoyed learning how to make a PCB, but I still think I'll avoid using that in my future projects...

So after that, I made the site plan. Here's a screenshot of it:

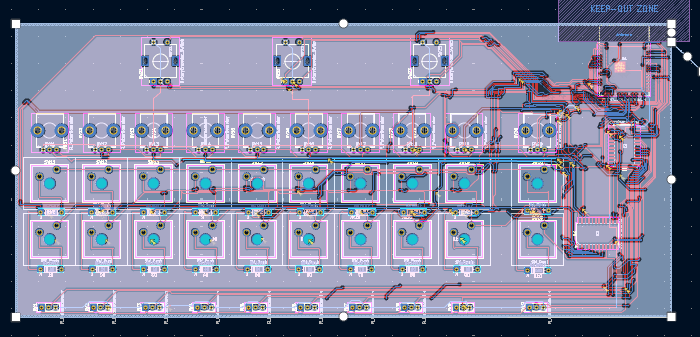
[picture p64: images/img-22.png]


And then, I generated all the file needed to order the PCB. You can check it [juste here](KiCad - MIDI-controller/MIDI-controller.kicad_pcb.zip). 

The PCP will be 241x108mm. I put that on JLCPCB, and it say only 13$ for the board ! That's a great news.

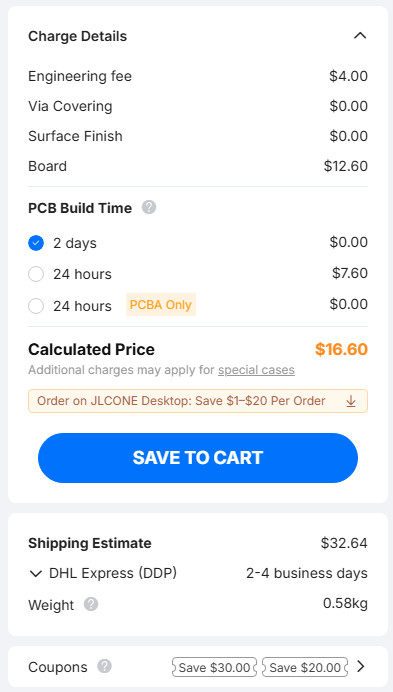
[picture p65: images/img-23.png]


So, to sum up, all I have left to do is export the PCB in 3D, create the 3D enclosure, and generate the final BOM and README. I also need to write the entire code. We are curently at ~100$ to build the MIDI controller, depending on the price of the deleverie for the PCB.

**Total time spent: 4 hours**

# Day 7: Coding and checking all of the project

Today I have a lot of time, and I don't want to touch Fusion or KiCad. So I want to make the entire codebase for the project.

So I started by doing the basic stuff and the ports configuration. You can check the file [hre](MIDI-controller-firmware.ino)

Here's how it's look:

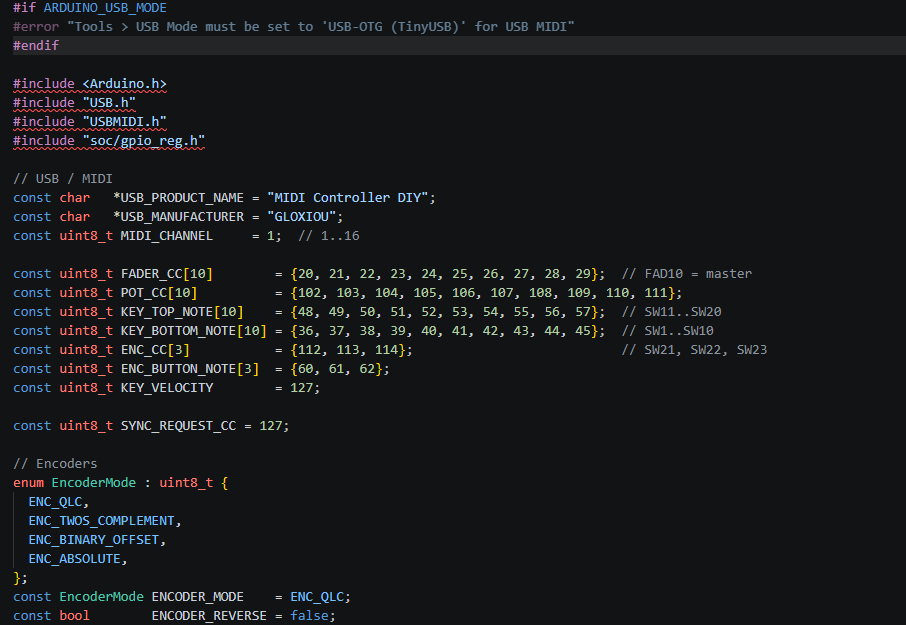
[picture p66: images/img-24.png]


Then, I made the MIDI output using [this link](https://www.qlcplus.org/forum/viewtopic.php?t=16926) and [that one](https://github.com/mcallegari/qlcplus/blob/master/engine/src/qlcinputsource.cpp) for the comptaibilite with QLC.
QLC is a lighning software that I use, and this MIDI controller is mean to be used with that. But normally, it will also be compatible with other software.

After that, I implemented the code for the matrix in this order: the buttons, the rotary encoders, and then the faders and potentiometers.

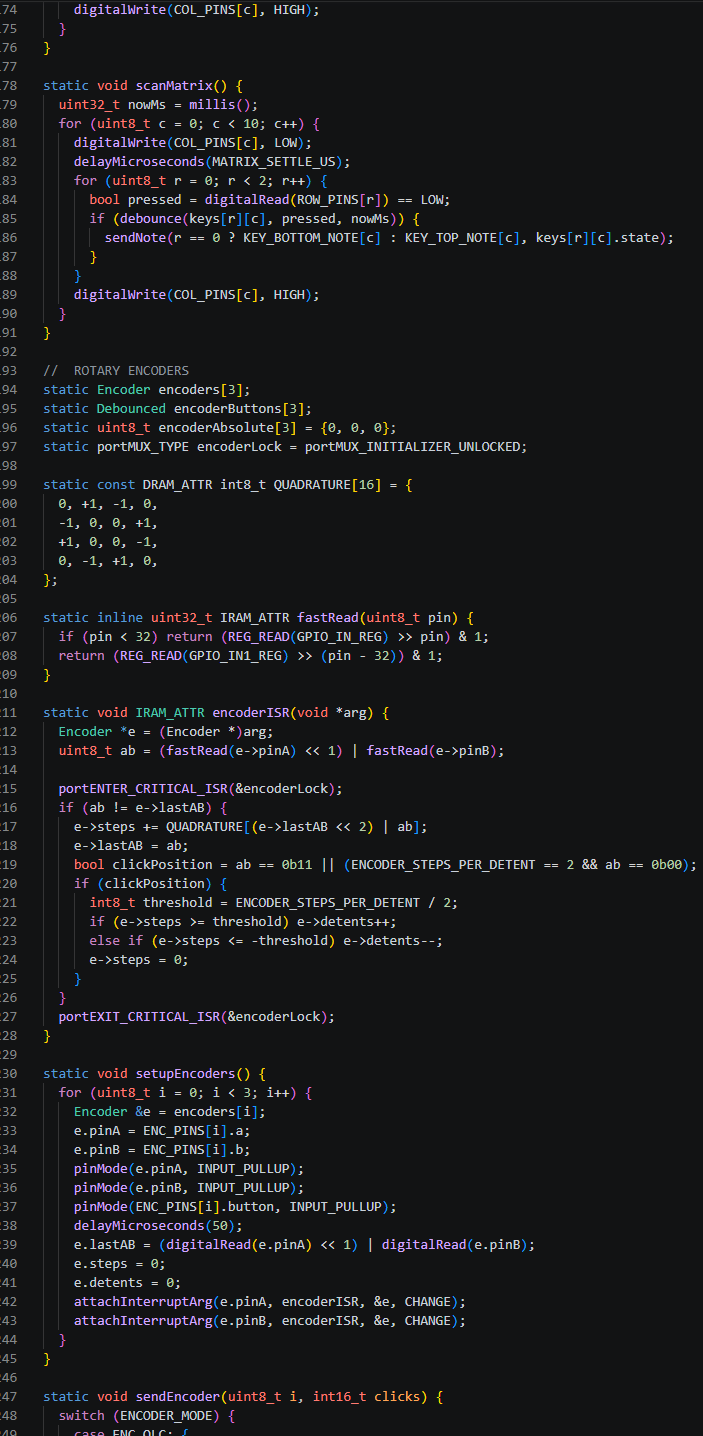
[picture p67: images/img-25.png]


And I finish by testing the entire code. I compiled it using the Arduino IDE, and this time I was even able to "test" it directly on the ESP32, since I already have one at home that I'm using for another project.

I got a lot of error message, and I spent a lot of time on this one before giving up and asking an LLM. The problem actually wasn't that complicated...
```Guru Meditation Error: Core panic'ed (Cache disabled but cached memory region accessed```
Just a message while sending a MIDI message from an interrupt or a callback.

The code wasn't the most annoying part today. The real trouble started when I went to write the README and ended up reviewing the whole project.

So in fact, in the KiCad model that I made, I used the wrong fingerpint for the ESP32, for the key switches, and for the WH148... So I need to change that. It shouldn't take very long, normally.

So, I'm thinking of buying Kailh Choc V1 switches instead of replacing the fingerprint sensor partly because they aren't that expensive, but mainly because a fingerprint sensor for my current switches simply doesn't exist.

If I do that, I might also switch the CD4067 from SOIC to the DIP-24 version, following a friend's recommendation. I also realized I'd forgotten the screw holes for the PCB... Rookie mistake!

So that’s it for today; I’ll check everything tomorrow. Hopefully, the PCB will be the right one this time. As for the overall price and the BOM, they will almost certainly change a little.

So, I still have the PCB to finish, the 3D case to make, the BOM, and the README, and then the project will be all set !

**Total time spent: 4 hours**

# Day 8: Fixing all the problemes of the project

Today I want to fix all the problems that I mention on day 7. That way, all that will remain is the 3D and the README.

I started by replacing the mounting points with the correct ones; they need to be connected properly. The screw holes have also been drilled.

![Image 26](images/img-26.png)

![Image 27](images/img-27.png)

You can see on the right that I've installed the right ESP32 this time, and that everything still needs to be connected...

![Image 28](images/img-28.png)

I also tried to optimize the space a bit; that's why the two MUX units were moved down and rotated the other way.
So then, I selected all the connections on the right and simply removed them:

![Image 29](images/img-29.png)

I think it's much simpler to start from scratch... Here come the faders:

![Image 30](images/img-30.png)

And the matrix and the rest connected to the ESP.

![Image 31](images/img-31.png)

So, putting it all together, this is the result. I had to tweak two or three other small things in the matrix to route the cables the way I wanted, and also because I changed the footprints, but it didn't take long.

![Image 32](images/img-32.png)

After that, of course, I created the ground planes just like last time, and I also exported the PCB in 3D so I can start working on the enclosure tomorrow:

![Image 33](images/img-33.png)

So now I'm finalizing the full BOM since I've also tested the PCB with the DRC, which no longer shows any errors. Here's it:

| Component | Quantity | Price |
| --- | --- | --- |
| [Kailh Choc V1 1350](https://fr.aliexpress.com/item/1005012826040037.html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) | 20 | 9.86$ |
| [RV09 B10K 8 mm vertical](https://fr.aliexpress.com/item/1005005951601744.html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) | 10 | 7.90$ |
| [EC11 through-hole with push-button, 20 mm shaft](https://fr.aliexpress.com/item/1005009889978797.html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) | 3 | 5.36$ |
| [CD4067BE in DIP-24](https://fr.aliexpress.com/item/1005011580802574.html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) | 2 | 6.69$ |
| [1N4148 diodes](https://fr.aliexpress.com/item/4000142272546.html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) | 20 | 1.64$ |
| [faders SC6021N 10k](https://fr.aliexpress.com/item/1005007799302164.html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) | 10 | 9$ |
| [ESP32-S3 N16R8](https://fr.aliexpress.com/item/1005008809316571.html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) | 1 | 8.02$ |
| [Knobs cap](https://fr.aliexpress.com/item/1005012925297636.html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) | 10 | 2.68$ |
| [PCB](https://jlcpcb.com/) | 1 | 16,60$ |
| [Lowprofile keycaps](https://fr.aliexpress.com/item/1005006624568390.html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) | 20 | 17.34$ |
| Total | --- | 85.09$ |

That does not include importztion taxes and deliverie.

I re-measured the PCB. It's 241x108. So, I'm going to check the price on JLCPCB:

![Image 34](images/img-34.png)

It seems to be the same price, which makes sense. Shipping is the most expensive part! It's the same thing for the componments on aliexpress...

I'm really happy with everything I got done today; there isn't much left to do on the project!

Tomorrow, I'm going to start the 3D model of the case.

**Total time spent: 4.5 hours**

# Day 9: Starting the 3D modeling

Hey ! So I started the day by making a folder for the firmware. You can check the file [here](firmware). And I also created a folder for the 3D modele. You can check it [here](3D-files).

I started the day by researching all the 3D models of the componments that was missing on the PCB to do the assembly on Fusion 360.

So what is missing is:
 * Everything except the 2 MUXes

I didn't find anything on the 100mm faders. When I made the PCB, I had the same issue with the footprints. So after a litlle bit of research, I realized that on the GrandMa, there is some 60mm standart faders. 

So, I’m going to replace the 100mm ones with 60mm ones throughout the project. That means I’ll need to redo the BOM, while also adding the covers for the knobs, faders, and keyboard keys. So the new faders will be the SC6021N 10k. It's 2.25$ for 3 faders.

I'm not redoing the PCB because it would take too much time, and besides, the PCB would cost a lot more for no reason.

 So I looked for all the components. Here are the files:
* [Kailh Choc V1 1350](3D-files/Kailh%20Choc%20Low%20Profile%20Switch.step)
* [RV09 B5K 8 mm vertical](3D-files/RV09%20B10K%209.step)
* [EC11 20 mm shaft](3D-files/EC11_Rotary_Encoder_Switched.step)
* [Diodes 1N4148](3D-files/Diode%201N4148.STEP)
* [Faders SC6021N 10k](3D-files/potentio_assem_asm.stp)
* [ESP32-S3 N16R8](3D-files/ESP32-S3-WROOM-1.STEP)

I found all the files on [GrabCad](https://grabcad.com/).

After that, I started the 3D model. This is going to be a very long process…

So I started by making the basic shape and support of the case:

![Image 35](images/img-35.png)

After that, I made all the wholes for the componments. That is not definitive, I will certainly change it tomorrow and I will do the assembly.

![Image 36](images/img-36.png)

Then, I Added a side cover and a cover for the faders. You can't see it on the Screenshot, but I also made the holes for thes screws:

![Image 37](images/img-37.png)

Then I made a litle hand support, and that took me so much time ! Like an hour just for that. I also made patterns on the sie to make everything more beautiful.

![Image 38](images/img-38.png)

And that's it for today ! It doesn't look like, but that took me a lonnnnggg time ! In addition, I'm still starting in 3D, so i'm quite slow...

**Total time spent: 4 hours**

# Day 10: Finishing the 3D modele and the assembly

So Today I want to make the full assembly, and then I will be able to export the printing files in STL.

I started by searchning all the step files that I needed on [GrabCAD](grabcad.com/Library). I put all the files in the [3D-files](3D-files) folder.

Then, I imported that into Fusion 360, in addition of the PCB.

![Image 39](images/img-39.png)

After that, I imported the bx and put most of the componments in their location:

![Image 40](images/img-40.png)

And then I put the whole thing in the box.

![Image 41](images/img-41.png)

After that, I adde the faders and the keycaps for the keyboards keys. And I Added my  litlle logo on the right top.

![Image 42](images/img-42.png)

So Here's finnaly finished ! Here's some Screenshot of the assembly 100% finished:

![Image 43](images/img-43.png)

![Image 44](images/img-44.png)

![Image 45](images/img-45.png)

![Image 46](images/img-46.png)

The case is 273mm x 250mm x 60mm.

**Total time spent: 3.5 hours**

# Day 11: Verification and README

Today the project will normaly be finished. I started by checking everything, the BOM, the 3D, the firmware, re-tested it IRL, check every files… That took me about an hour.

Then I made the [readme](README.md) file.

Here's a look at it:

![img-47](images/img-47.png)

I also made a [bom](BOM.csv) file.

And just like that, this huge project is finished !

**Total time spent: 2 hours**

# Day 12: Litlle modification on the 3D

Hey !

Today, even if I already submit to review the project, I just want to change a cuplle of thing on the project, especially on the 3D files.

Looking back at the project and the GrandMa Wing, my source of inspiration, I’ve come up with a few little ideas. Nothing too crazy ! I think it’ll be quick to put together.

So I started by straighten the controller because it was a litlle difficult to work on that like that, and thn I removed my G logo that I printed on the case. In fact that's a open source project, so afetr a bit of a reflexion, that's not good to just put my logo like that. That took me juste 5min...

Here's how it look like know:

![img-48](images/img-48.png)

After that, I just filled the gap that looked odd on the left. I took some measurements and then replicated the same gap on the left that was already on the right. The one on the right conceals the ESP32. I also repositioned the master fader so it’s aligned with its corresponding keyboard keys. The same applies to all the other faders.

![img-49](images/img-49.png)

Then I made some calculations for the faders, knobs, etc. The current faders are a few millimeters too low to fit a cap, so I’ll need to sort that out.

I started by making a cap for a knob, then for a rotary encoder, and finally for a fader.

![img-50](images/img-50.png)

It took a very long time ! But this way, I can simply duplicate all of these and copy them onto the other components.

![img-51](images/img-51.png)

And after some exports, the project is 100% finished this time ! You can check the new files [here](3D-files/assembly-Midi-controller-DIY.step) for the assembly (I didn't add any STEP file), and just [here](3D-files/to%20print/) for the new file to print, including the knobs and everything.

So after that I apdated a litlle bit the README, and here are a few screenshots of the new box:

![img-52](images/img-52.png)

![img-53](images/img-53.png)

![img-54](images/img-54.png)

**Total time spent: 3.5 hours**
