GLOXIOU/MIDI-controller-DIY/KiCad - MIDI-controller/KiCad - MIDI-controller.kicad_pcb

## KiCad design KiCad - MIDI-controller/KiCad - MIDI-controller.kicad_pcb (2026-10-06)

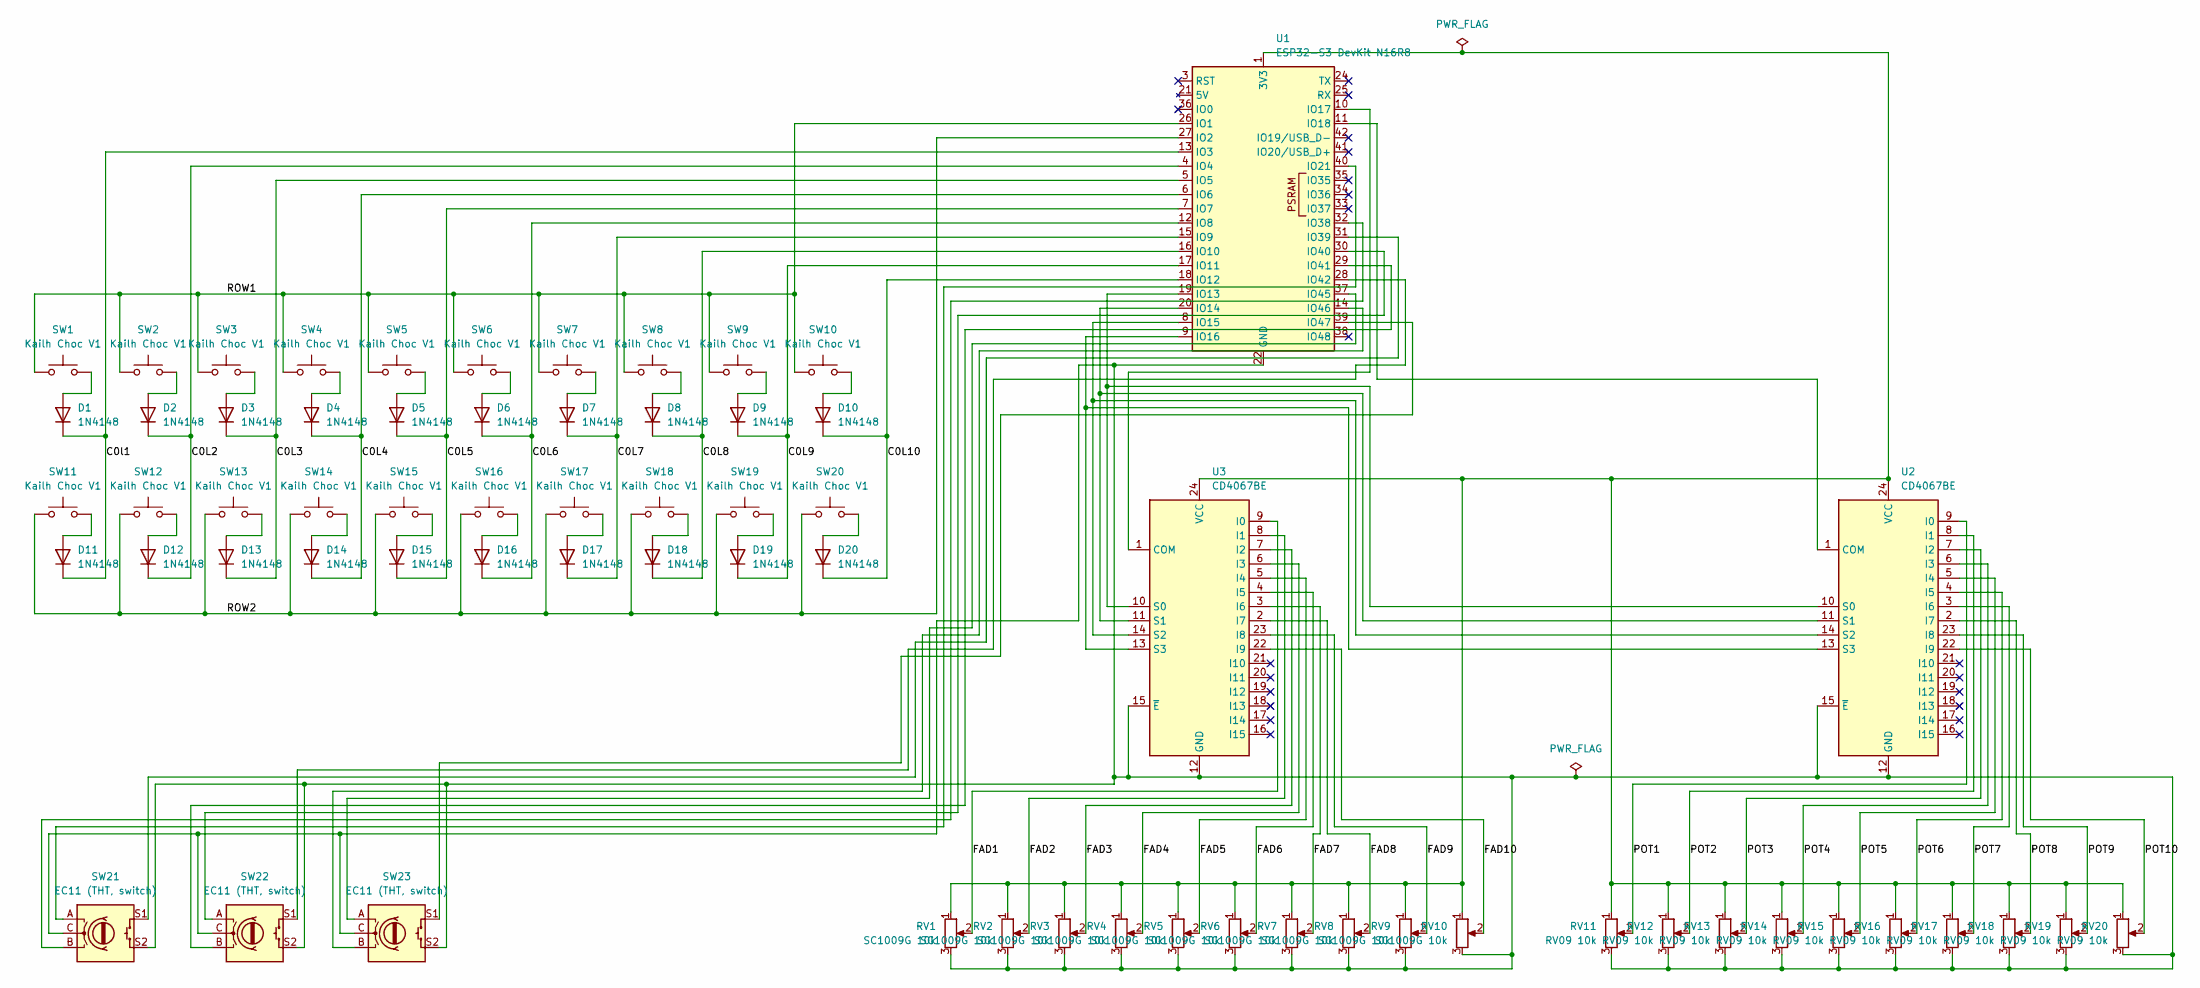
[picture p68: schematic KiCad - MIDI-controller.kicad_sch]

Parts:
D1, D2, D3, D4, D5, D6, D7, D8, D9, D10, D11, D12, D13, D14, D15, D16, D17, D18, D19, D20: 1N4148; D_DO-35_SOD27_P7.62mm_Horizontal
RV1, RV2, RV3, RV4, RV5, RV6, RV7, RV8, RV9, RV10: SC1009G 10k; PinHeader_1x03_P2.54mm_Vertical
RV11, RV12, RV13, RV14, RV15, RV16, RV17, RV18, RV19, RV20: RV09 10k; Potentiometer_Bourns_PTV09A-1_Single_Vertical
SW1, SW2, SW3, SW4, SW5, SW6, SW7, SW8, SW9, SW10, SW11, SW12, SW13, SW14, SW15, SW16, SW17, SW18, SW19, SW20: Kailh Choc V1; SW_Kailh_Choc_V1_1.00u
SW21, SW22, SW23: EC11 (THT, switch); RotaryEncoder_Alps_EC11E-Switch_Vertical_H20mm
U1: ESP32-S3 DevKit N16R8; ESP32-S3-DevKitC-1_44P_W25.4mm
U2, U3: CD4067BE; DIP-24_W15.24mm

Connections:
/C0L2: D2.1 (K), D12.1 (K), U1.4 (IO4)
/C0L3: D3.1 (K), D13.1 (K), U1.5 (IO5)
/C0L4: D4.1 (K), D14.1 (K), U1.6 (IO6)
/C0L5: D5.1 (K), D15.1 (K), U1.7 (IO7)
/C0L6: D6.1 (K), D16.1 (K), U1.12 (IO8)
/C0L7: D7.1 (K), D17.1 (K), U1.15 (IO9)
/C0L8: D8.1 (K), D18.1 (K), U1.16 (IO10)
/C0L9: D9.1 (K), D19.1 (K), U1.17 (IO11)
/C0L10: D10.1 (K), D20.1 (K), U1.18 (IO12)
/C0l1: D1.1 (K), D11.1 (K), U1.13 (IO3)
/FAD1: RV1.2, U3.9 (I0)
/FAD2: RV2.2, U3.8 (I1)
/FAD3: RV3.2, U3.7 (I2)
/FAD4: RV4.2, U3.6 (I3)
/FAD5: RV5.2, U3.5 (I4)
/FAD6: RV6.2, U3.4 (I5)
/FAD7: RV7.2, U3.3 (I6)
/FAD8: RV8.2, U3.2 (I7)
/FAD9: RV9.2, U3.23 (I8)
/FAD10: RV10.2, U3.22 (I9)
/POT1: RV11.2, U2.9 (I0)
/POT2: RV12.2, U2.8 (I1)
/POT3: RV13.2, U2.7 (I2)
/POT4: RV14.2, U2.6 (I3)
/POT5: RV15.2, U2.5 (I4)
/POT6: RV16.2, U2.4 (I5)
/POT7: RV17.2, U2.3 (I6)
/POT8: RV18.2, U2.2 (I7)
/POT9: RV19.2, U2.23 (I8)
/POT10: RV20.2, U2.22 (I9)
/ROW1: SW1.1, SW2.1, SW3.1, SW4.1, SW5.1, SW6.1, SW7.1, SW8.1, SW9.1, SW10.1, U1.26 (IO1)
/ROW2: SW11.1, SW12.1, SW13.1, SW14.1, SW15.1, SW16.1, SW17.1, SW18.1, SW19.1, SW20.1, U1.27 (IO2)
unnamed: D1.2 (A), SW1.2
unnamed: D2.2 (A), SW2.2
unnamed: D3.2 (A), SW3.2
unnamed: D4.2 (A), SW4.2
unnamed: D5.2 (A), SW5.2
unnamed: D6.2 (A), SW6.2
unnamed: D7.2 (A), SW7.2
unnamed: D8.2 (A), SW8.2
unnamed: D9.2 (A), SW9.2
unnamed: D10.2 (A), SW10.2
unnamed: D11.2 (A), SW11.2
unnamed: D12.2 (A), SW12.2
unnamed: D13.2 (A), SW13.2
unnamed: D14.2 (A), SW14.2
unnamed: D15.2 (A), SW15.2
unnamed: D16.2 (A), SW16.2
unnamed: D17.2 (A), SW17.2
unnamed: D18.2 (A), SW18.2
unnamed: D19.2 (A), SW19.2
unnamed: D20.2 (A), SW20.2
unnamed: U1.19 (IO13), U2.10 (S0), U3.10 (S0)
unnamed: U1.20 (IO14), U2.11 (S1), U3.11 (S1)
unnamed: U1.8 (IO15), U2.14 (S2), U3.14 (S2)
unnamed: U1.9 (IO16), U2.13 (S3), U3.13 (S3)
unnamed: U1.10 (IO17), U3.1 (COM)
unnamed: U1.11 (IO18), U2.1 (COM)
unnamed: SW21.A, U1.40 (IO21)
unnamed: SW21.B, U1.32 (IO38)
unnamed: SW21.S1, U1.31 (IO39)
unnamed: SW22.A, U1.30 (IO40)
unnamed: SW22.B, U1.29 (IO41)
unnamed: SW22.S1, U1.28 (IO42)
unnamed: SW23.A, U1.37 (IO45)
unnamed: SW23.B, U1.14 (IO46)
unnamed: SW23.S1, U1.39 (IO47)
unnamed: RV1.3, RV2.3, RV3.3, RV4.3, RV5.3, RV6.3, RV7.3, RV8.3, RV9.3, RV10.3, RV11.3, RV12.3, RV13.3, RV14.3, RV15.3, RV16.3, RV17.3, RV18.3, RV19.3, RV20.3, SW21.C, SW21.S2, SW22.C, SW22.S2, SW23.C, SW23.S2, U1.22 (GND), U1.23 (GND), U1.43 (GND), U1.44 (GND), U2.12 (GND), U2.15 (~E), U3.12 (GND), U3.15 (~E)
unnamed: RV1.1, RV2.1, RV3.1, RV4.1, RV5.1, RV6.1, RV7.1, RV8.1, RV9.1, RV10.1, RV11.1, RV12.1, RV13.1, RV14.1, RV15.1, RV16.1, RV17.1, RV18.1, RV19.1, RV20.1, U1.1 (3V3), U1.2 (3V3), U2.24 (VCC), U3.24 (VCC)

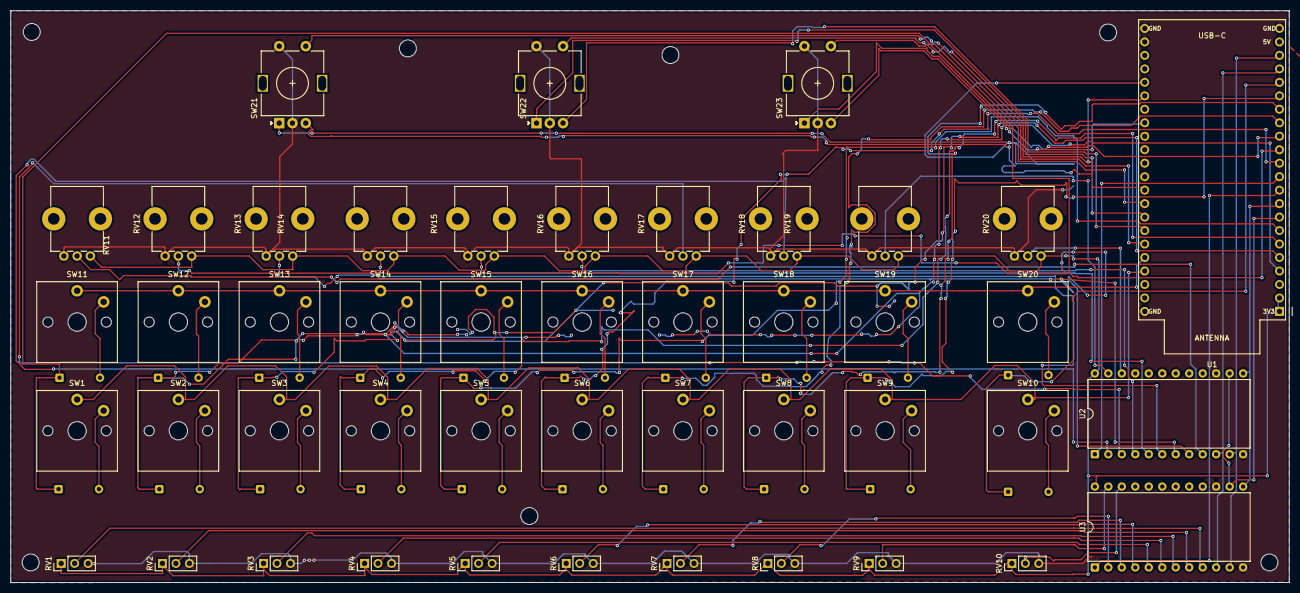
[picture p69: board KiCad - MIDI-controller.kicad_pcb from above]

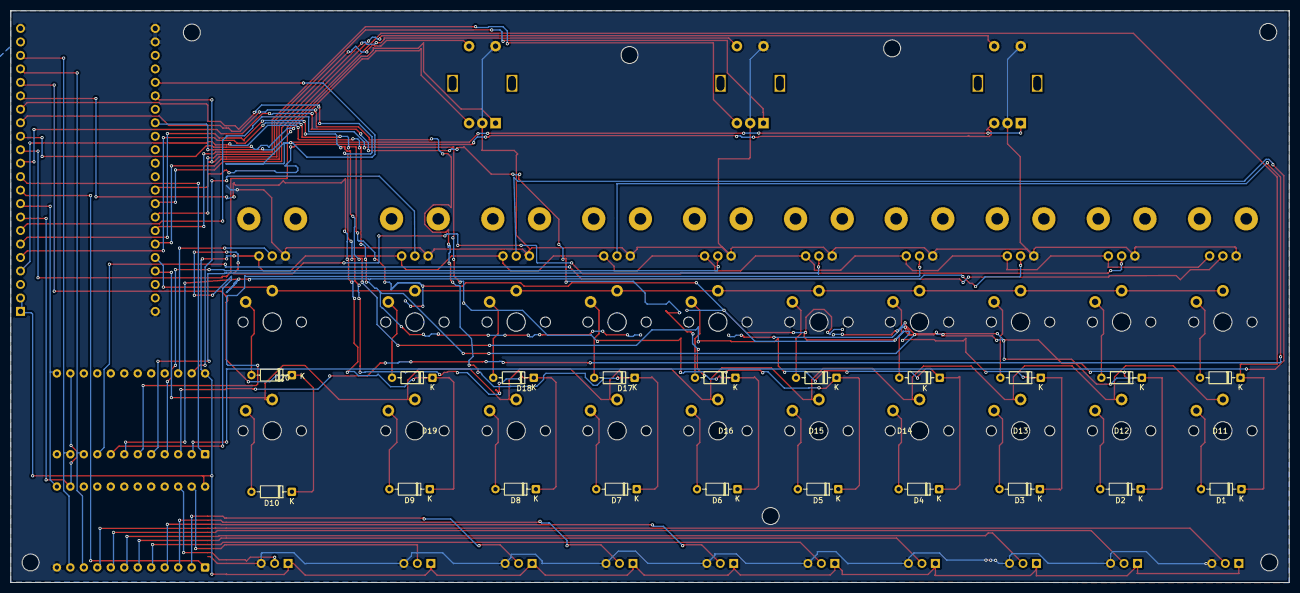
[picture p70: board KiCad - MIDI-controller.kicad_pcb from below]

Board: 2 copper layers, 241.0 x 107.8 mm, 73 parts (20 on the bottom side), 69 nets.

Other parts of the board:
H1, H2, H3, H4, H5, H6, H7: M3; MountingHole_3.2mm_M3
