GLOXIOU/MIDI-controller-DIY/(commit log)

2026-09-27 Day 2
    [KiCad - MIDI-controller.kicad_pcb, KiCad - MIDI-controller.kicad_sch]
2026-09-28 Day 3
    [KiCad - MIDI-controller.kicad_sch]
2026-09-29 Day 4
    [KiCad - MIDI-controller.kicad_pcb, KiCad - MIDI-controller.kicad_sch]
2026-10-02 Day 5
    [KiCad - MIDI-controller.kicad_pcb]
2026-10-04 Day 6
    [KiCad - MIDI-controller-B_Cu.gbr, KiCad - MIDI-controller-B_Mask.gbr, KiCad - MIDI-controller-B_Paste.gbr, KiCad - MIDI-controller-B_Silkscreen.gbr, KiCad - MIDI-controller-Edge_Cuts.gbr, KiCad - MIDI-controller-F_Cu.gbr, KiCad - MIDI-controller-F_Mask.gbr, KiCad - MIDI-controller-F_Paste.gbr]
2026-10-06 Day 8
    [KiCad - MIDI-controller-B_Cu.gbl, KiCad - MIDI-controller-B_Cu.gbr, KiCad - MIDI-controller-B_Mask.gbr, KiCad - MIDI-controller-B_Mask.gbs, KiCad - MIDI-controller-B_Paste.gbp, KiCad - MIDI-controller-B_Silkscreen.gbo, KiCad - MIDI-controller-Edge_Cuts.gm1, KiCad - MIDI-controller-F_Cu.gbr]
2026-10-31 Update journal with project completion details
    Added images and references to README and BOM files.
2026-11-01 Update JOURNAL.md with 3D modeling progress
    Documented the research and decisions regarding 3D modeling components, including fader replacements and BOM updates.
